pddenhar/hw_microRusEfi/microRusEfi.kicad_pcb

## KiCad design microRusEfi.kicad_pcb (2019-11-08)

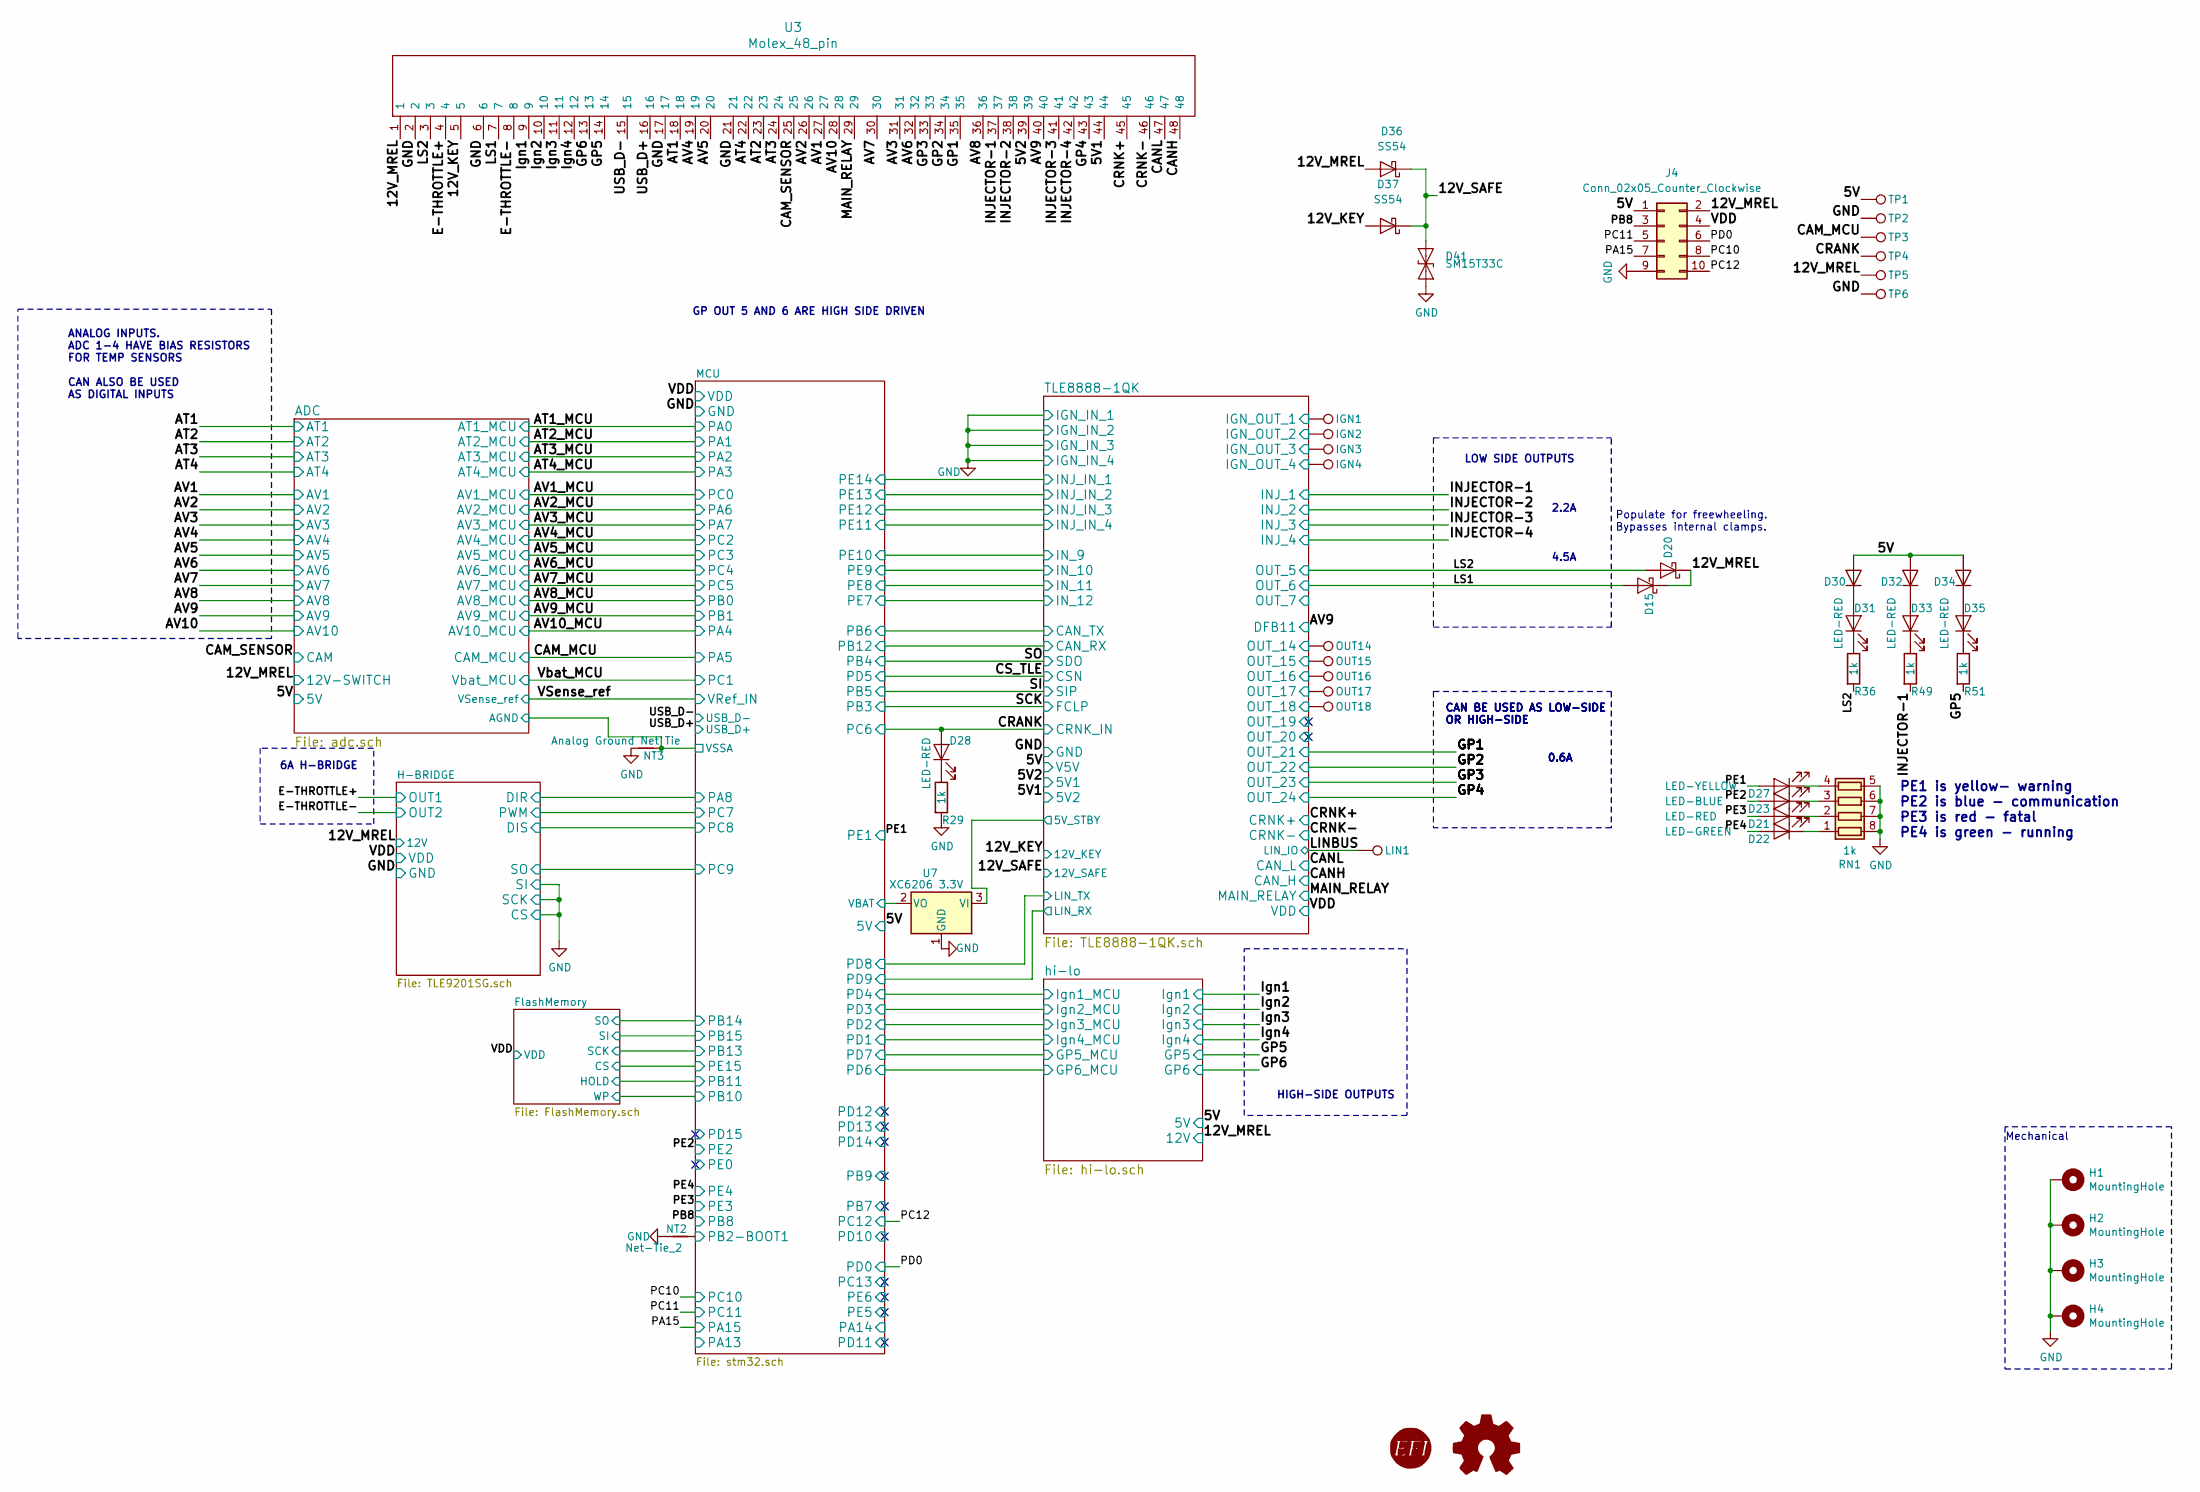
[picture p1: schematic microRusEfi.sch, microRusEfi-2L]

Parts:
D15, D20: DNP; D_SOD-323; Part # NSR0530HT
D21: LED-RED; LED_0805_2012Metric; LCSC C84256
D22: LED-GREEN; LED_0805_2012Metric; LCSC C2297
D23: LED-BLUE; LED_0805_2012Metric; LCSC C2293
D27: LED-YELLOW; LED_0805_2012Metric; LCSC C2296
D28: LED-RED; LED_0603_1608Metric; Part # LTST-C193TBKT-5A; LCSC C2286
D30, D32, D34: 1N4148WS; D_SOD-323; Part # NSR0530HT; LCSC C2128
D31, D33, D35: LED-RED; LED_0603_1608Metric; Part # LTST-S270KRKT; LCSC C2286
D36, D37: SS54; D_SMA; LCSC C22452
D41: SM15T33C; D_SMC
H1, H2, H3, H4: MountingHole; MountingHole_3.5mm_Pad_Via; Part # DNP
IGN1, IGN2, IGN3, IGN4: IGNOUT; Pin_D0.7mm_L6.5mm_W1.8mm_FlatFork; Part # DNP
J4: Conn_02x05_Counter_Clockwise; PinHeader_2x05_P2.54mm_Vertical_SMD
LIN1: LIN; PinHeader_1x01_P2.54mm_Vertical; Part # DNP
LOGO1: DNP; LogoMRE; Part # DNP
LOGO2: DNP; LOGO; Part # DNP
NT2: Net-Tie_2; Net-Tie_2_8.5mil
NT3: Analog Ground Net Tie; NetTie-2_SMD_Pad0.5mm
OUT14: OUT14; Pin_D0.7mm_L6.5mm_W1.8mm_FlatFork; Part # DNP
OUT15: OUT15; Pin_D0.7mm_L6.5mm_W1.8mm_FlatFork; Part # DNP
OUT16: OUT16; Pin_D0.7mm_L6.5mm_W1.8mm_FlatFork; Part # DNP
OUT17: OUT17; Pin_D0.7mm_L6.5mm_W1.8mm_FlatFork; Part # DNP
OUT18: OUT18; Pin_D0.7mm_L6.5mm_W1.8mm_FlatFork; Part # DNP
R29, R36, R49, R51: 1k; R_0603_1608Metric; Part # RMCF0603JJ1K00; LCSC C21190
RN1: 1k; R_Array_Convex_4x0603; Part # CAT16-1001F4LF; LCSC C20197
TP1, TP5: 5V; TestPoint_Pad_D2.0mm; Part # DNP
TP2, TP6: GND; TestPoint_Pad_D2.0mm; Part # DNP
TP3, TP4: TP; TestPoint_Pad_D2.0mm; Part # DNP
U3: Molex_48_pin; Molex_48; Part # 500762-0481
U7: XC6206 3.3V; SOT-23; LCSC C5446

Connections:
/5V: D30.2 (A), D32.2 (A), D34.2 (A), J4.1, TP1.1; also elsewhere on the board
/5V1: U3.44; also elsewhere on the board
/5V2: U3.39; also elsewhere on the board
/12V_KEY: D37.2 (A), U3.5; also elsewhere on the board
/12V_MREL: D15.1 (K), D20.1 (K), D36.2 (A), J4.2, TP5.1, U3.1; also elsewhere on the board
/12V_SAFE: D36.1 (K), D37.1 (K), D41.1 (A1); also elsewhere on the board
/ADC/AGND: NT3.2; also elsewhere on the board
/AT1: U3.18; also elsewhere on the board
/AT2: U3.23; also elsewhere on the board
/AT3: U3.24; also elsewhere on the board
/AT4: U3.22; also elsewhere on the board
/AV1: U3.27; also elsewhere on the board
/AV2: U3.26; also elsewhere on the board
/AV3: U3.31; also elsewhere on the board
/AV4: U3.19; also elsewhere on the board
/AV5: U3.20; also elsewhere on the board
/AV6: U3.32; also elsewhere on the board
/AV7: U3.30; also elsewhere on the board
/AV8: U3.36; also elsewhere on the board
/AV9: U3.40; also elsewhere on the board
/AV10: U3.28; also elsewhere on the board
/CAM_MCU: TP3.1; also elsewhere on the board
/CAM_SENSOR: U3.25; also elsewhere on the board
/CANH: U3.48; also elsewhere on the board
/CANL: U3.47; also elsewhere on the board
/CRANK: D28.2 (A), TP4.1; also elsewhere on the board
/CRNK+: U3.45; also elsewhere on the board
/CRNK-: U3.46; also elsewhere on the board
/E-THROTTLE+: U3.4; also elsewhere on the board
/E-THROTTLE-: U3.8; also elsewhere on the board
/GP1: U3.35; also elsewhere on the board
/GP2: U3.34; also elsewhere on the board
/GP3: U3.33; also elsewhere on the board
/GP4: U3.43; also elsewhere on the board
/GP5: R51.2, U3.14; also elsewhere on the board
/GP6: U3.13; also elsewhere on the board
/INJECTOR-1: R49.2, U3.37; also elsewhere on the board
/INJECTOR-2: U3.38; also elsewhere on the board
/INJECTOR-3: U3.41; also elsewhere on the board
/INJECTOR-4: U3.42; also elsewhere on the board
/Ign1: U3.9; also elsewhere on the board
/Ign2: U3.10; also elsewhere on the board
/Ign3: U3.11; also elsewhere on the board
/Ign4: U3.12; also elsewhere on the board
/LINBUS: LIN1.1; also elsewhere on the board
/LS1: D15.2 (A), U3.7; also elsewhere on the board
/LS2: D20.2 (A), R36.2, U3.3; also elsewhere on the board
/MAIN_RELAY: U3.29; also elsewhere on the board
/MCU/PB2-BOOT1: NT2.2; also elsewhere on the board
/MCU/VBAT: U7.2 (VO); also elsewhere on the board
/PA15: J4.7; also elsewhere on the board
/PB8: J4.3; also elsewhere on the board
/PC10: J4.8; also elsewhere on the board
/PC11: J4.5; also elsewhere on the board
/PC12: J4.10; also elsewhere on the board
/PD0: J4.6; also elsewhere on the board
/PE1: D27.2 (A); also elsewhere on the board
/PE2: D23.2 (A); also elsewhere on the board
/PE3: D21.2 (A); also elsewhere on the board
/PE4: D22.2 (A); also elsewhere on the board
/TLE8888-1QK/5V_STBY: U7.3 (VI); also elsewhere on the board
/TLE8888-1QK/IGN_OUT_1: IGN1.1; also elsewhere on the board
/TLE8888-1QK/IGN_OUT_2: IGN2.1; also elsewhere on the board
/TLE8888-1QK/IGN_OUT_3: IGN3.1; also elsewhere on the board
/TLE8888-1QK/IGN_OUT_4: IGN4.1; also elsewhere on the board
/TLE8888-1QK/OUT_14: OUT14.1; also elsewhere on the board
/TLE8888-1QK/OUT_15: OUT15.1; also elsewhere on the board
/TLE8888-1QK/OUT_16: OUT16.1; also elsewhere on the board
/TLE8888-1QK/OUT_17: OUT17.1; also elsewhere on the board
/TLE8888-1QK/OUT_18: OUT18.1; also elsewhere on the board
/USB_D+: U3.16; also elsewhere on the board
/USB_D-: U3.15; also elsewhere on the board
/VDD: J4.4; also elsewhere on the board
GND: D41.2 (A2), H1.1, H2.1, H3.1, H4.1, J4.9, NT2.1, NT3.1, R29.2, RN1.5 (R4.2), RN1.6 (R3.2), RN1.7 (R2.2), RN1.8 (R1.2), TP2.1, TP6.1, U3.2, U3.6, U3.17, U3.21, U7.1 (GND); also elsewhere on the board
unnamed: D21.1 (K), RN1.2 (R2.1)
unnamed: D22.1 (K), RN1.1 (R1.1)
unnamed: D23.1 (K), RN1.3 (R3.1)
unnamed: D27.1 (K), RN1.4 (R4.1)
unnamed: D28.1 (K), R29.1
unnamed: D30.1 (K), D31.2 (A)
unnamed: D31.1 (K), R36.1
unnamed: D32.1 (K), D33.2 (A)
unnamed: D33.1 (K), R49.1
unnamed: D34.1 (K), D35.2 (A)
unnamed: D35.1 (K), R51.1

Notes on the sheet:
LOW SIDE OUTPUTS
4.5A
0.6A
2.2A
HIGH-SIDE OUTPUTS
ANALOG INPUTS. ADC 1-4 HAVE BIAS RESISTORS FOR TEMP SENSORS CAN ALSO BE USED AS DIGITAL INPUTS
CAN BE USED AS LOW-SIDE OR HIGH-SIDE
GP OUT 5 AND 6 ARE HIGH SIDE DRIVEN
6A H-BRIDGE
PE1 is yellow- warning PE2 is blue - communication PE3 is red - fatal PE4 is green - running
Populate for freewheeling. Bypasses internal clamps.
Mechanical

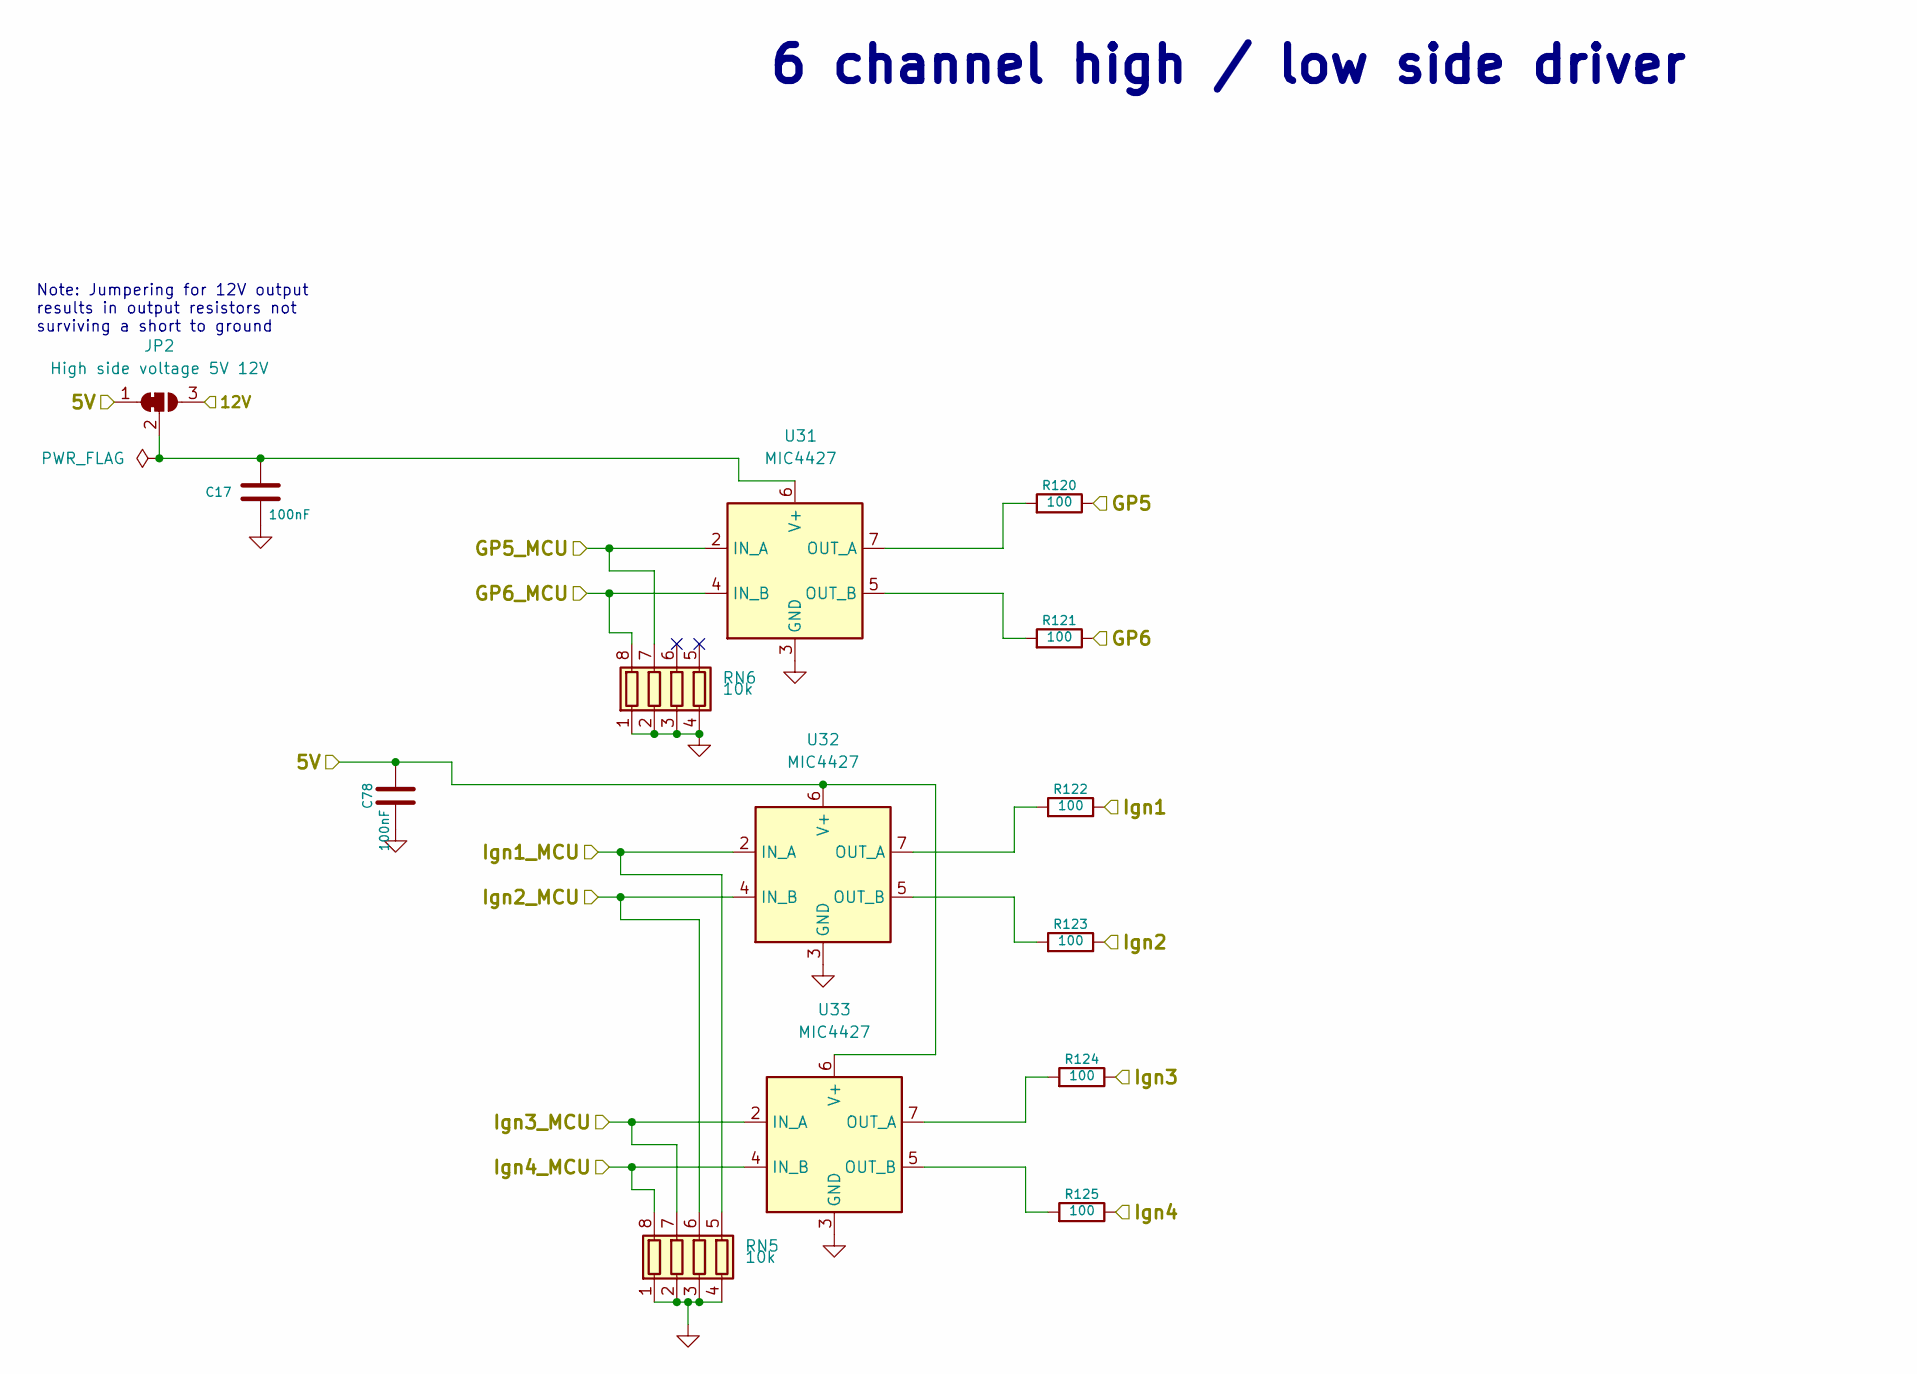
[picture p2: schematic hi-lo.sch, microRusEfi-2L]

Parts:
C17, C78: 100nF; C_0603_1608Metric; LCSC C14663
JP2: High side voltage 5V 12V; SolderJumper-3_P1.3mm_Bridged2Bar12_Pad1.0x1.5mm
R120, R121, R122, R123, R124, R125: 100; R_1206_3216Metric; Part # RMCF0603FT100R; LCSC C17901
RN5, RN6: 10k; R_Array_Convex_4x0603; LCSC C29718
U31, U32, U33: MIC4427; SOIC-8_3.9x4.9mm_P1.27mm; LCSC C144205

Connections:
/5V: C78.1, JP2.1 (A), U32.6 (V+), U33.6 (V+); also elsewhere on the board
/12V_MREL: JP2.3 (B); also elsewhere on the board
/GP5: R120.1; also elsewhere on the board
/GP6: R121.1; also elsewhere on the board
/Ign1: R122.1; also elsewhere on the board
/Ign2: R123.1; also elsewhere on the board
/Ign3: R124.1; also elsewhere on the board
/Ign4: R125.1; also elsewhere on the board
/hi-lo/GP5_MCU: RN6.7 (R2.2), U31.2 (IN_A); also elsewhere on the board
/hi-lo/GP6_MCU: RN6.8 (R1.2), U31.4 (IN_B); also elsewhere on the board
/hi-lo/Ign1_MCU: RN5.5 (R4.2), U32.2 (IN_A); also elsewhere on the board
/hi-lo/Ign2_MCU: RN5.6 (R3.2), U32.4 (IN_B); also elsewhere on the board
/hi-lo/Ign3_MCU: RN5.7 (R2.2), U33.2 (IN_A); also elsewhere on the board
/hi-lo/Ign4_MCU: RN5.8 (R1.2), U33.4 (IN_B); also elsewhere on the board
GND: C17.2, C78.2, RN5.1 (R1.1), RN5.2 (R2.1), RN5.3 (R3.1), RN5.4 (R4.1), RN6.1 (R1.1), RN6.2 (R2.1), RN6.3 (R3.1), RN6.4 (R4.1), U31.3 (GND), U32.3 (GND), U33.3 (GND); also elsewhere on the board
unnamed: C17.1, JP2.2 (C), U31.6 (V+)
unnamed: R120.2, U31.7 (OUT_A)
unnamed: R121.2, U31.5 (OUT_B)
unnamed: R122.2, U32.7 (OUT_A)
unnamed: R123.2, U32.5 (OUT_B)
unnamed: R124.2, U33.7 (OUT_A)
unnamed: R125.2, U33.5 (OUT_B)

Notes on the sheet:
6 channel high / low side driver
Note: Jumpering for 12V output results in output resistors not surviving a short to ground

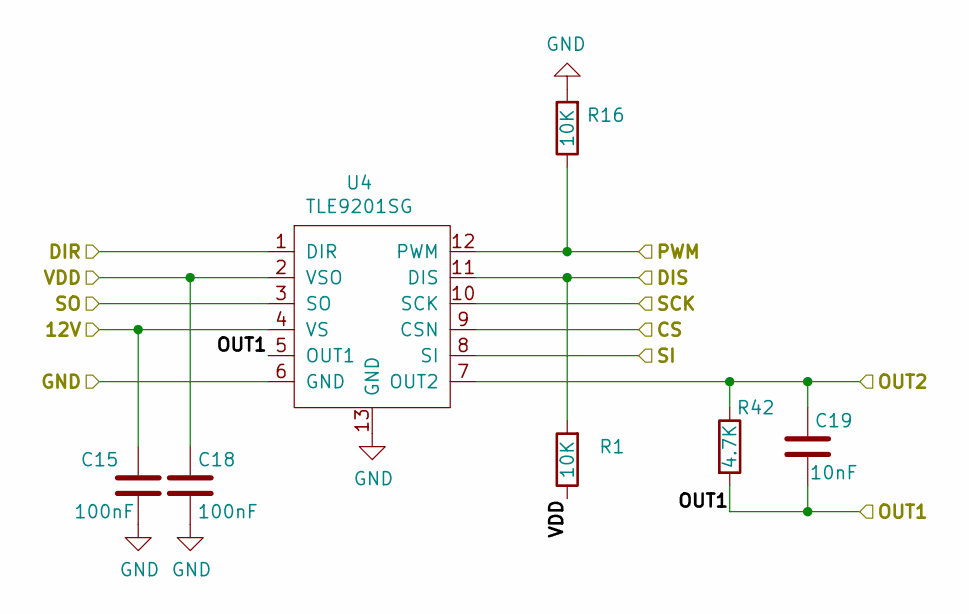
[picture p3: schematic TLE9201SG.sch, microRusEfi-2L]

Parts:
C15, C18: 100nF; C_0603_1608Metric; Part # C0603C104J5RACTU; LCSC C14663
C19: 10nF; C_0603_1608Metric; Part # C0603C103K1RACTU; LCSC C57112
R1, R16: 10K; R_0603_1608Metric; Part # RMCF0603JT10K0; LCSC C25804
R42: 4.7K; R_0603_1608Metric; Part # RMCF0603JT4K70; LCSC C23162
U4: TLE9201SG; Infineon_PG-DSO-12-11; Part # TLE9201SG

Connections:
/12V_MREL: C15.1, U4.4 (VS); also elsewhere on the board
/E-THROTTLE+: C19.2, R42.2, U4.5 (OUT1); also elsewhere on the board
/E-THROTTLE-: C19.1, R42.1, U4.7 (OUT2); also elsewhere on the board
/H-BRIDGE/DIR: U4.1 (DIR); also elsewhere on the board
/H-BRIDGE/DIS: R1.2, U4.11 (DIS); also elsewhere on the board
/MCU/PC7: R16.1, U4.12 (PWM); also elsewhere on the board
/MCU/PC9: U4.3 (SO); also elsewhere on the board
/VDD: C18.1, R1.1, U4.2 (VSO); also elsewhere on the board
GND: C15.2, C18.2, R16.2, U4.6 (GND), U4.8 (SI), U4.9 (CSN), U4.10 (SCK), U4.13 (GND); also elsewhere on the board

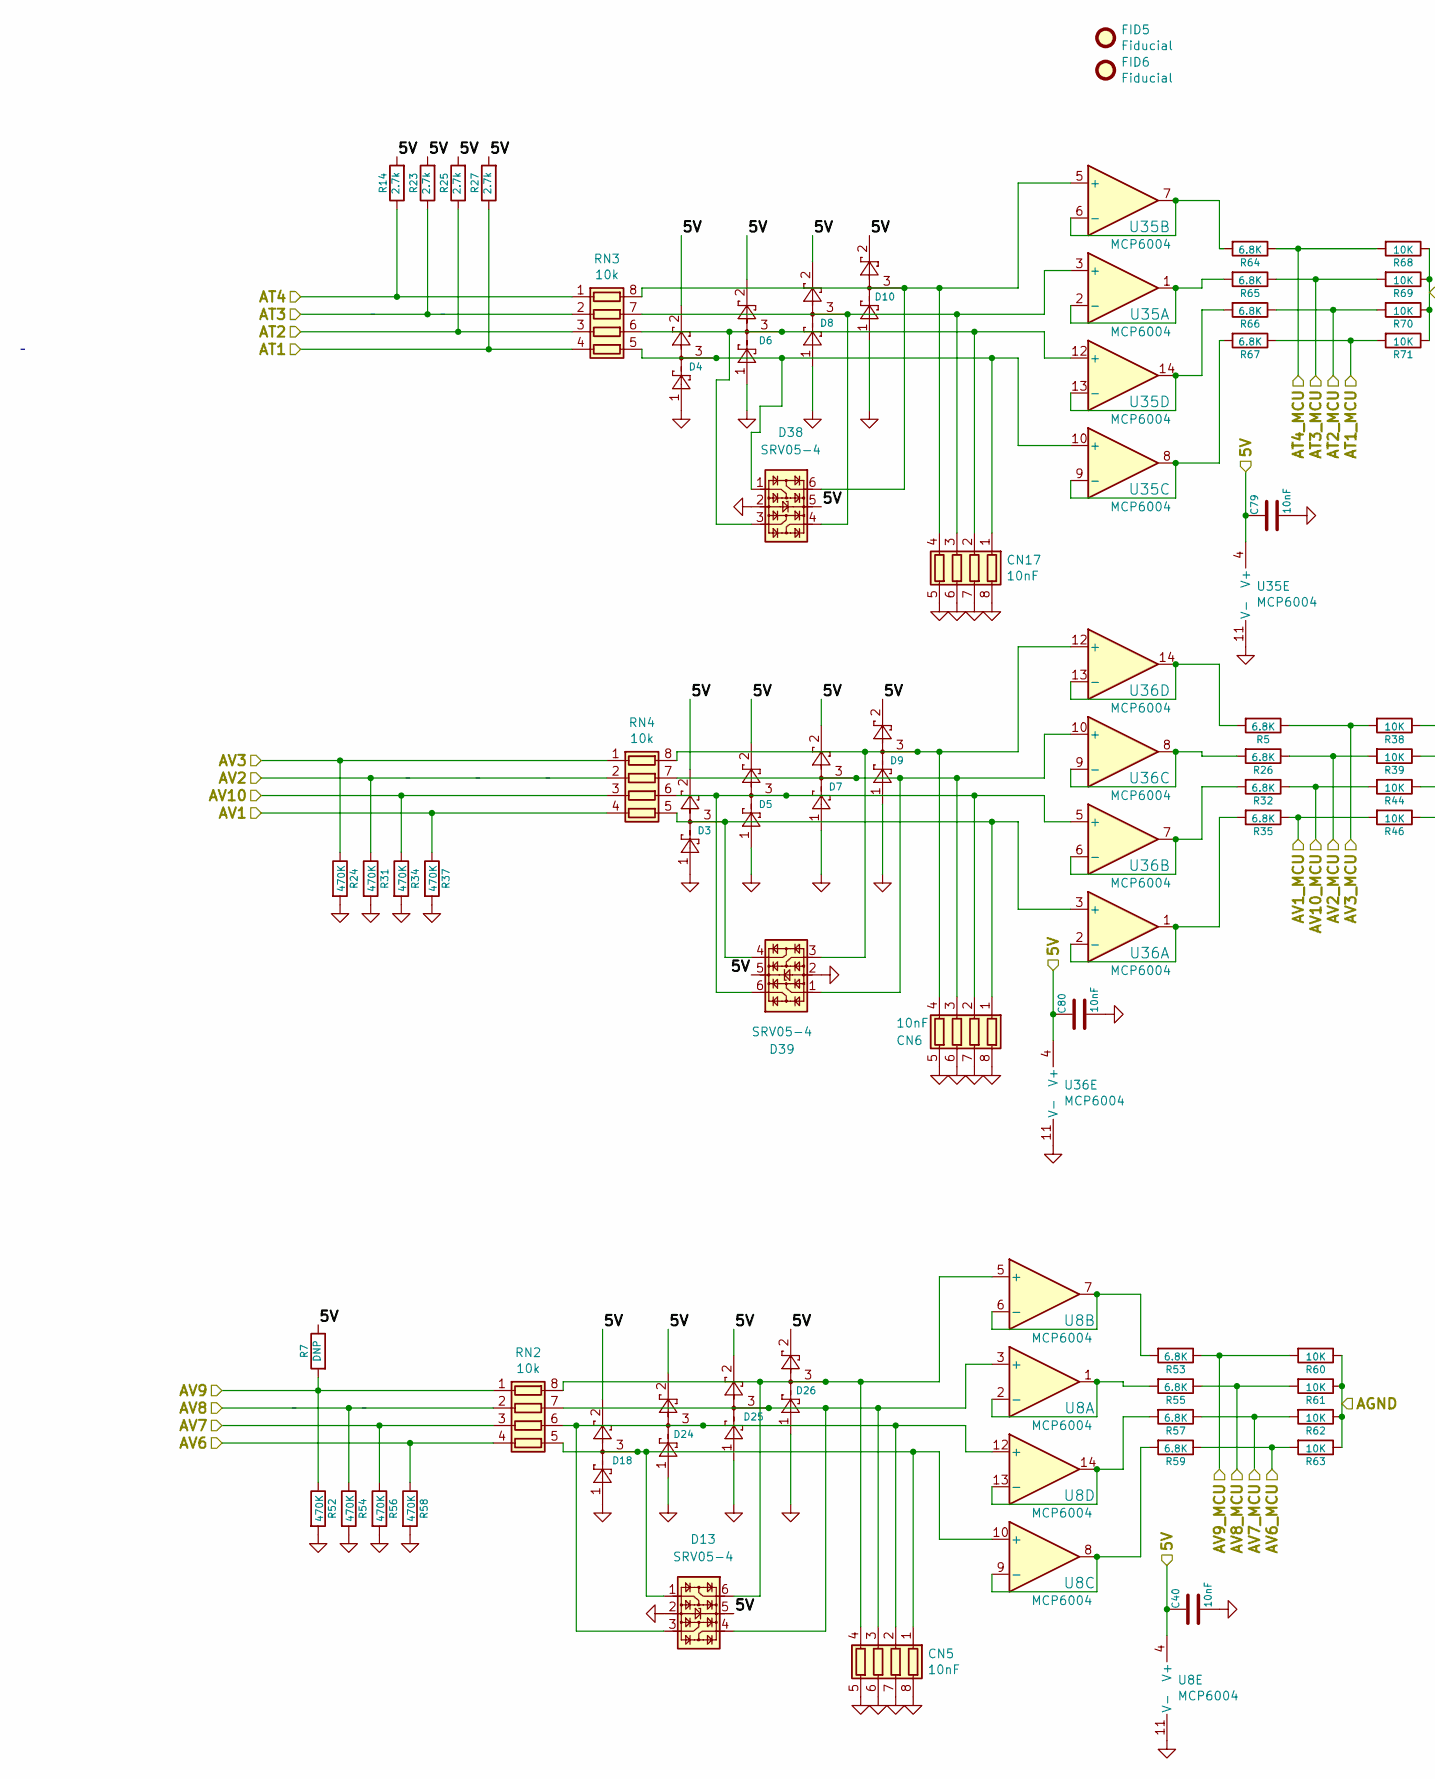
[picture p4: schematic adc.sch, microRusEfi-2L, part in row 1, column 1]

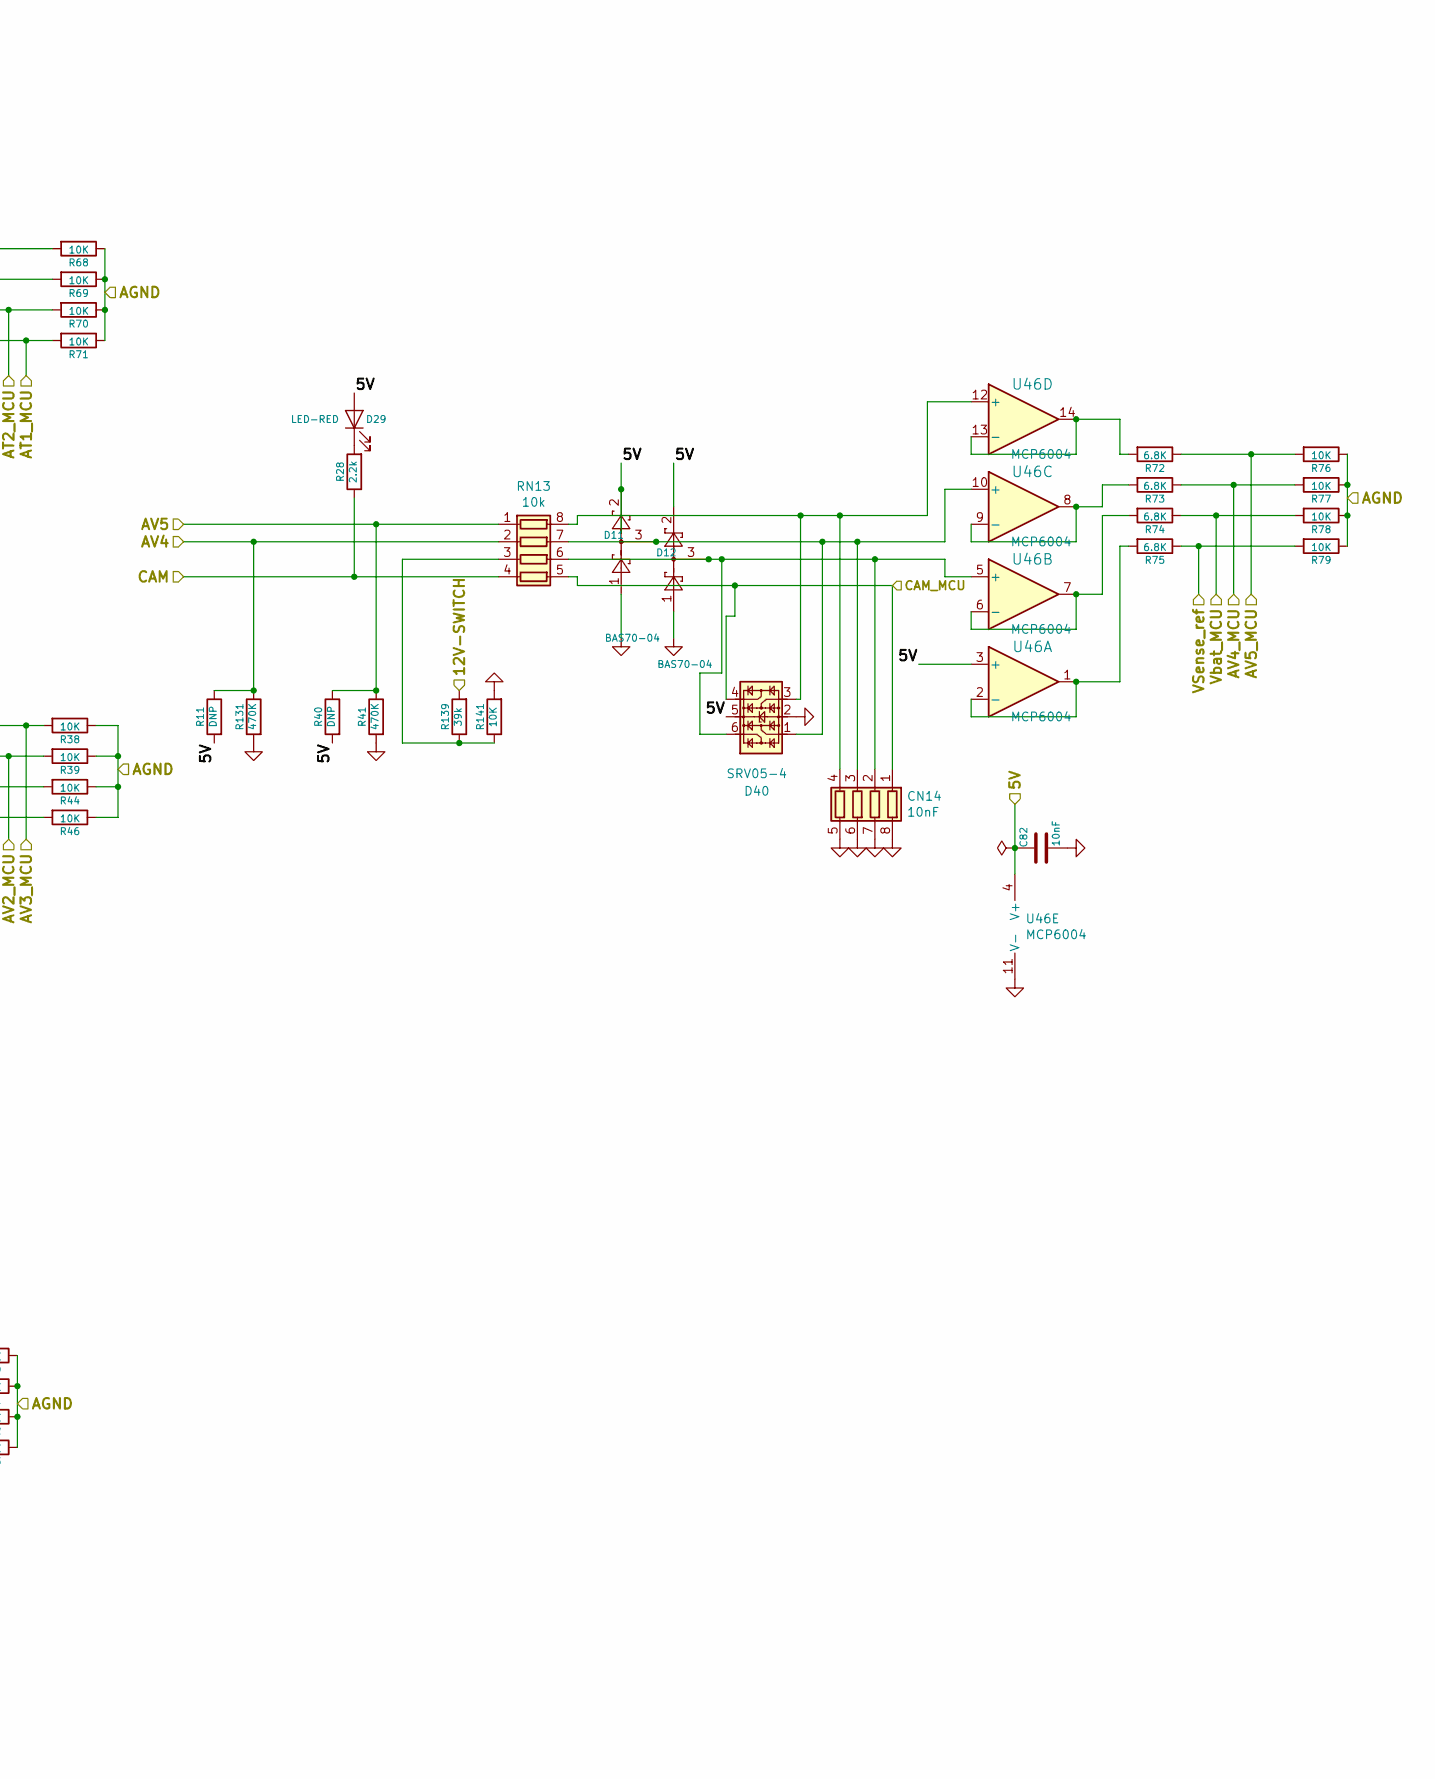
[picture p5: schematic adc.sch, microRusEfi-2L, part in row 1, column 2]

Parts:
C40, C79, C80, C82: 10nF; C_0603_1608Metric; Part # C0603C103K1RACTU; LCSC C57112
CN5, CN6, CN14, CN17: 10nF; R_Array_Convex_4x0603; Part # CA064X103K2RACAUTO
D3, D4, D5, D6, D7, D8, D9, D10, D11, D12, D18, D24, D25, D26: BAS70-04; SOT-23; Part # SBAS70-04LT1G
D13, D38, D39, D40: SRV05-4; SOT-23-6; LCSC C85364
D29: LED-RED; LED_0603_1608Metric; Part # LTST-C193TBKT-5A; LCSC C2286
FID5, FID6: Fiducial; Fiducial_0.5mm_Mask1mm; Part # DNP
R5, R26, R32, R35, R53, R55, R57, R59, R64, R65, R66, R67, R72, R73, R74, R75: 6.8K; R_0603_1608Metric; LCSC C23212
R7, R11, R40: DNP; R_0603_1608Metric; Part # DNP
R14, R23, R25, R27: 2.7k; R_0603_1608Metric; Part # RMCF0603FT2K70; LCSC C13167
R24, R31, R34, R37, R41, R52, R54, R56, R58, R131: 470K; R_0603_1608Metric; Part # RMCF0603FT470K; LCSC C23178
R28: 2.2k; R_0603_1608Metric; Part # RMCF0603FT2K20; LCSC C4190
R38, R39, R44, R46, R60, R61, R62, R63, R68, R69, R70, R71, R76, R77, R78, R79: 10K; R_0603_1608Metric; LCSC C25804
R139: 39k; R_0603_1608Metric; Part # RC0603FR-0739KL; LCSC C23153
R141: 10K; R_0603_1608Metric; Part # RMCF0603JT10K0; LCSC C25804
RN2, RN3, RN4, RN13: 10k; R_Array_Convex_4x0603; Part # YC164-JR-0710KL; LCSC C29718
U8, U35, U36, U46: MCP6004; TSSOP-14_4.4x5mm_P0.65mm; Part # MCP6004T-I/ST; LCSC C50282

Connections:
/5V: C40.1, C79.1, C80.1, C82.1, D3.2, D4.2, D5.2, D6.2, D7.2, D8.2, D9.2, D10.2, D11.2, D12.2, D13.5, D18.2, D24.2, D25.2, D26.2, D29.2 (A), D38.5, D39.5, D40.5, R7.1, R11.2, R14.2, R23.2, R25.2, R27.2, R40.2, U8.4 (V+), U35.4 (V+), U36.4 (V+), U46.3 (+), U46.4 (V+); also elsewhere on the board
/12V_MREL: R139.2; also elsewhere on the board
/ADC/AGND: R38.1, R39.1, R44.1, R46.1, R60.1, R61.1, R62.1, R63.1, R68.1, R69.1, R70.1, R71.1, R76.1, R77.1, R78.1, R79.1; also elsewhere on the board
/AT1: R27.1, RN3.4 (R4.1); also elsewhere on the board
/AT1_MCU: R67.1, R71.2; also elsewhere on the board
/AT2: R25.1, RN3.3 (R3.1); also elsewhere on the board
/AT2_MCU: R66.1, R70.2; also elsewhere on the board
/AT3: R23.1, RN3.2 (R2.1); also elsewhere on the board
/AT3_MCU: R65.1, R69.2; also elsewhere on the board
/AT4: R14.1, RN3.1 (R1.1); also elsewhere on the board
/AT4_MCU: R64.1, R68.2; also elsewhere on the board
/AV1: R37.1, RN4.4 (R4.1); also elsewhere on the board
/AV1_MCU: R35.1, R46.2; also elsewhere on the board
/AV2: R31.1, RN4.2 (R2.1); also elsewhere on the board
/AV2_MCU: R26.1, R39.2; also elsewhere on the board
/AV3: R24.1, RN4.1 (R1.1); also elsewhere on the board
/AV3_MCU: R5.1, R38.2; also elsewhere on the board
/AV4: R11.1, R131.1, RN13.2 (R2.1); also elsewhere on the board
/AV4_MCU: R73.1, R77.2; also elsewhere on the board
/AV5: R40.1, R41.1, RN13.1 (R1.1); also elsewhere on the board
/AV5_MCU: R72.1, R76.2; also elsewhere on the board
/AV6: R58.1, RN2.4 (R4.1); also elsewhere on the board
/AV6_MCU: R59.1, R63.2; also elsewhere on the board
/AV7: R56.1, RN2.3 (R3.1); also elsewhere on the board
/AV7_MCU: R57.1, R62.2; also elsewhere on the board
/AV8: R54.1, RN2.2 (R2.1); also elsewhere on the board
/AV8_MCU: R55.1, R61.2; also elsewhere on the board
/AV9: R7.2, R52.1, RN2.1 (R1.1); also elsewhere on the board
/AV9_MCU: R53.1, R60.2; also elsewhere on the board
/AV10: R34.1, RN4.3 (R3.1); also elsewhere on the board
/AV10_MCU: R32.1, R44.2; also elsewhere on the board
/CAM_MCU: CN14.1 (R1.1), D40.4, RN13.5 (R4.2); also elsewhere on the board
/CAM_SENSOR: R28.1, RN13.4 (R4.1); also elsewhere on the board
/VSense_ref: R75.1, R79.2; also elsewhere on the board
/Vbat_MCU: R74.1, R78.2; also elsewhere on the board
GND: C40.2, C79.2, C80.2, C82.2, CN5.5 (R4.2), CN5.6 (R3.2), CN5.7 (R2.2), CN5.8 (R1.2), CN6.5 (R4.2), CN6.6 (R3.2), CN6.7 (R2.2), CN6.8 (R1.2), CN14.5 (R4.2), CN14.6 (R3.2), CN14.7 (R2.2), CN14.8 (R1.2), CN17.5 (R4.2), CN17.6 (R3.2), CN17.7 (R2.2), CN17.8 (R1.2), D3.1, D4.1, D5.1, D6.1, D7.1, D8.1, D9.1, D10.1, D11.1, D12.1, D13.2, D18.1, D24.1, D25.1, D26.1, D38.2, D39.2, D40.2, R24.2, R31.2, R34.2, R37.2, R41.2, R52.2, R54.2, R56.2, R58.2, R131.2, R141.2, U8.11 (V-), U35.11 (V-), U36.11 (V-), U46.11 (V-); also elsewhere on the board
unnamed: CN5.1 (R1.1), D13.1, D18.3, RN2.5 (R4.2), U8.10 (+)
unnamed: CN5.2 (R2.1), D13.3, D24.3, RN2.6 (R3.2), U8.12 (+)
unnamed: CN5.3 (R3.1), D13.4, D25.3, RN2.7 (R2.2), U8.3 (+)
unnamed: CN5.4 (R4.1), D13.6, D26.3, RN2.8 (R1.2), U8.5 (+)
unnamed: CN6.1 (R1.1), D3.3, D39.4, RN4.5 (R4.2), U36.3 (+)
unnamed: CN6.2 (R2.1), D5.3, D39.6, RN4.6 (R3.2), U36.5 (+)
unnamed: CN6.3 (R3.1), D7.3, D39.1, RN4.7 (R2.2), U36.10 (+)
unnamed: CN6.4 (R4.1), D9.3, D39.3, RN4.8 (R1.2), U36.12 (+)
unnamed: CN14.2 (R2.1), D12.3, D40.6, RN13.6 (R3.2), U46.5 (+)
unnamed: CN14.3 (R3.1), D11.3, D40.1, RN13.7 (R2.2), U46.10 (+)
unnamed: CN14.4 (R4.1), D40.3, RN13.8 (R1.2), U46.12 (+)
unnamed: CN17.1 (R1.1), D4.3, D38.1, RN3.5 (R4.2), U35.10 (+)
unnamed: CN17.2 (R2.1), D6.3, D38.3, RN3.6 (R3.2), U35.12 (+)
unnamed: CN17.3 (R3.1), D8.3, D38.4, RN3.7 (R2.2), U35.3 (+)
unnamed: CN17.4 (R4.1), D10.3, D38.6, RN3.8 (R1.2), U35.5 (+)
unnamed: D29.1 (K), R28.2
unnamed: R5.2, U36.13 (-), U36.14
unnamed: R26.2, U36.8, U36.9 (-)
unnamed: R32.2, U36.6 (-), U36.7
unnamed: R35.2, U36.1, U36.2 (-)
unnamed: R53.2, U8.6 (-), U8.7
unnamed: R55.2, U8.1, U8.2 (-)
unnamed: R57.2, U8.13 (-), U8.14
unnamed: R59.2, U8.8, U8.9 (-)
unnamed: R64.2, U35.6 (-), U35.7
unnamed: R65.2, U35.1, U35.2 (-)
unnamed: R66.2, U35.13 (-), U35.14
unnamed: R67.2, U35.8, U35.9 (-)
unnamed: R72.2, U46.13 (-), U46.14
unnamed: R73.2, U46.8, U46.9 (-)
unnamed: R74.2, U46.6 (-), U46.7
unnamed: R75.2, U46.1, U46.2 (-)
unnamed: R139.1, R141.1, RN13.3 (R3.1)
