pddenhar/hw_microRusEfi/microRusEfi.kicad_pcb

## KiCad design microRusEfi.kicad_pcb (continued)

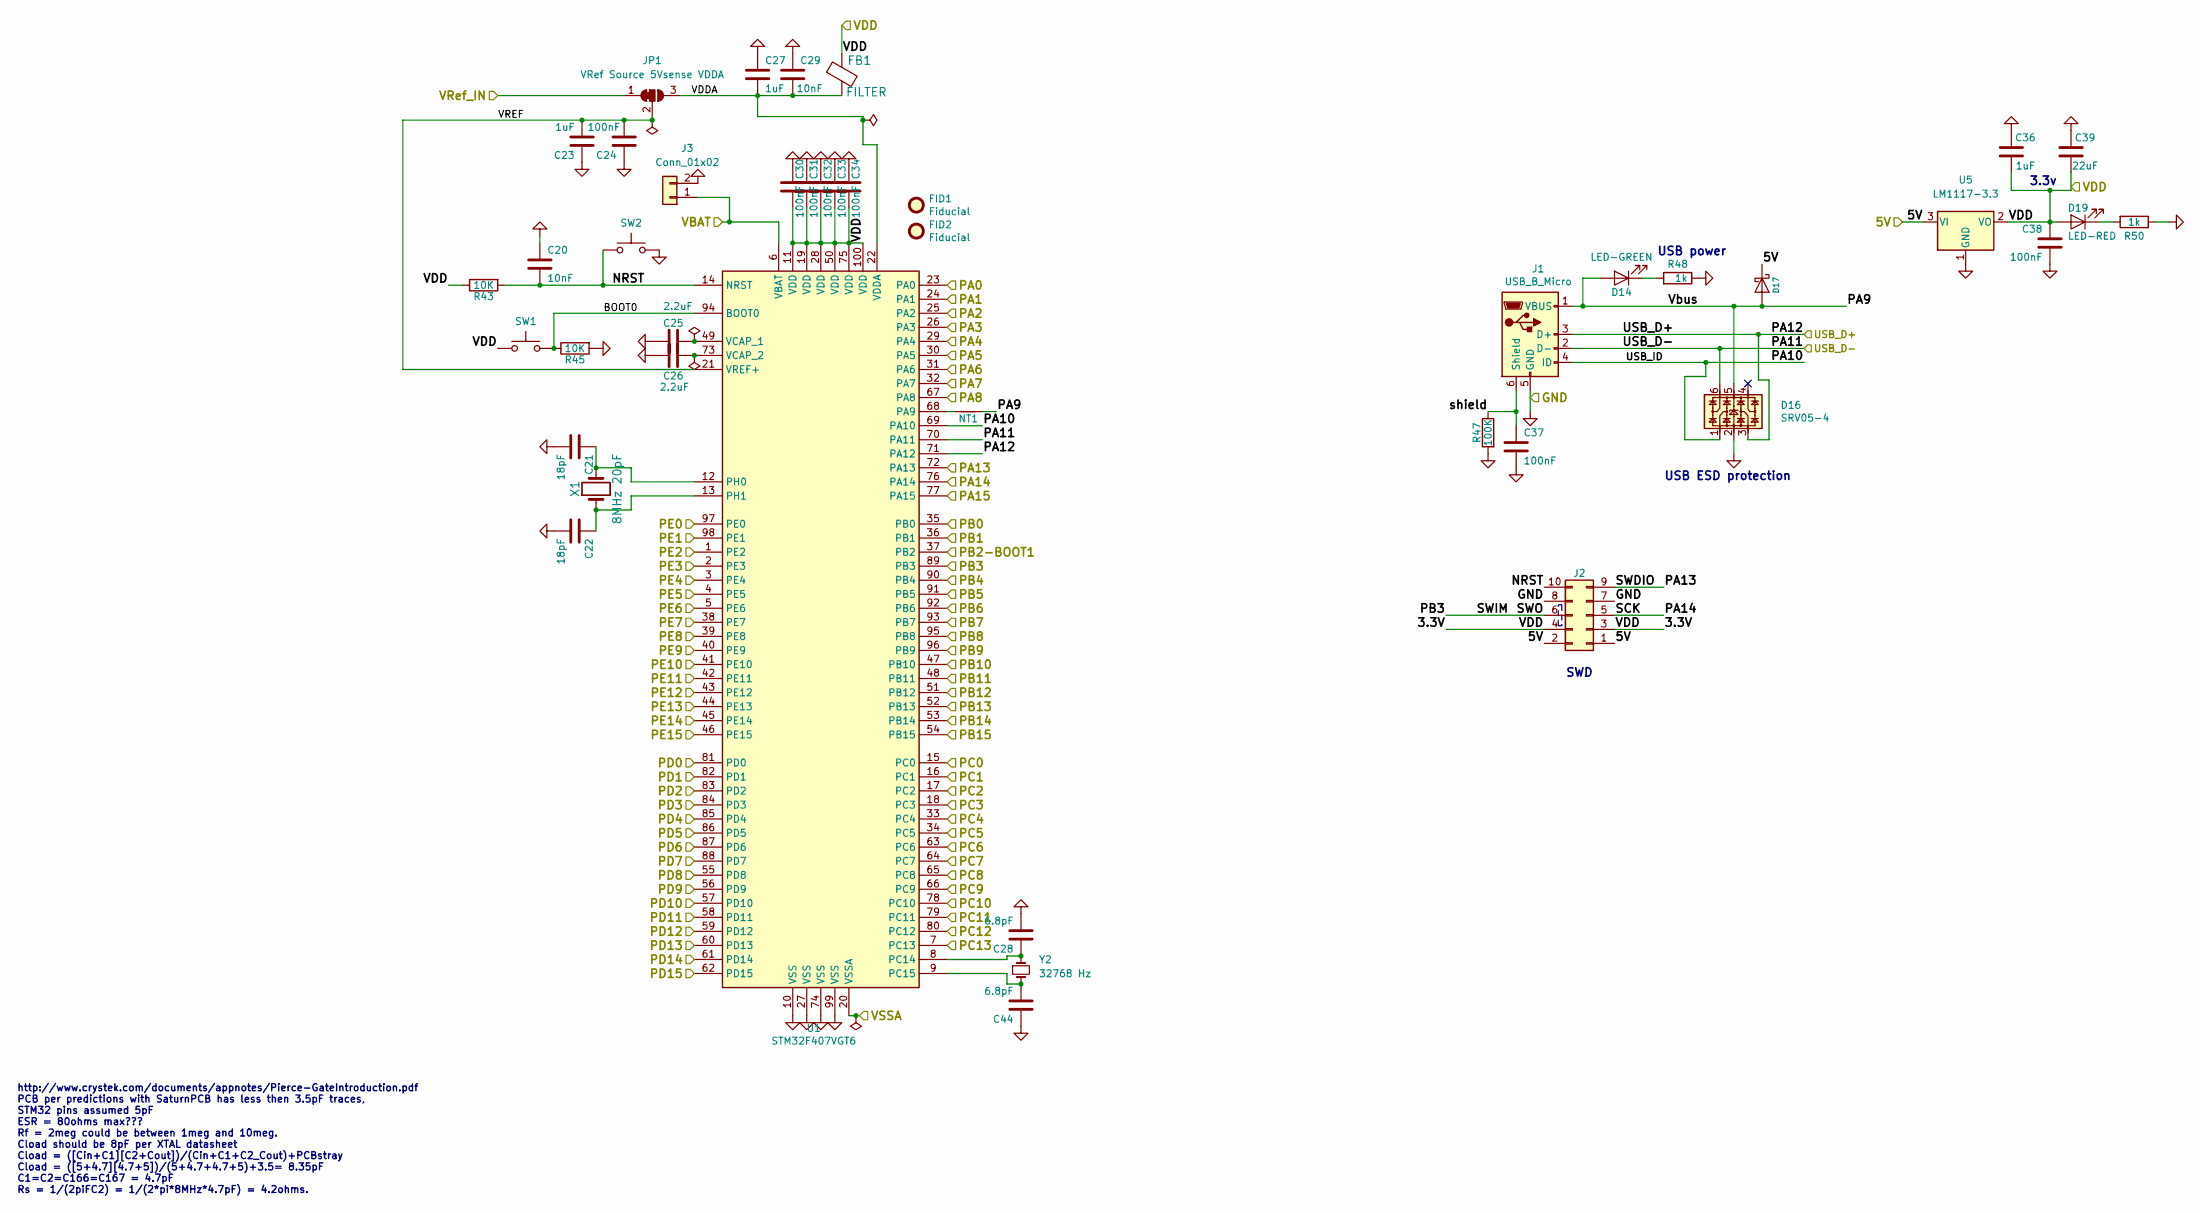
[picture p6: schematic stm32.sch, microRusEfi-2L]

Parts:
C20, C29: 10nF; C_0603_1608Metric; Part # C0603C103K1RACTU; LCSC C57112
C21, C22: 18pF; C_0603_1608Metric; Part # CC0603CRNPO9BN4R7; LCSC C1647
C23, C27, C36: 1uF; C_0603_1608Metric; Part # UMK107BJ105KA-T; LCSC C15849
C24, C30, C31, C32, C33, C34: 100nF; C_0603_1608Metric; LCSC C14663
C25, C26: 2.2uF; C_0603_1608Metric; Part # GRM188R6YA225KA12D; LCSC C23630
C28, C44: 6.8pF; C_0603_1608Metric; LCSC C1679
C37, C38: 100nF; C_0603_1608Metric; Part # C0603C104J5RACTU; LCSC C14663
C39: 22uF; C_0603_1608Metric; LCSC C59461
D14: LED-GREEN; C_0805_2012Metric; LCSC C2297
D16: SRV05-4; SOT-23-6; Part # SRV05-4; LCSC C85364
D17: B5819W; D_SOD-123; LCSC C8598
D19: LED-RED; LED_0603_1608Metric; LCSC C2286
FB1: FILTER; R_0603_1608Metric_Pad1.05x0.95mm_HandSolder; Part # BLM21PG221SN1D; LCSC C1034
FID1, FID2: Fiducial; Fiducial_0.5mm_Mask1mm; Part # DNP
J1: USB_B_Micro; USB_Micro-B_Wuerth-614105150721_Vertical; Part # USB3131-30-0230-A
J2: Conn_02x05_Odd_Even; PinSocket_2x05_P2.54mm_Vertical_SMD; Part # 95278-801B10LF
J3: Conn_01x02; Molex_PicoBlade_53047-0210_1x02_P1.25mm_Vertical
JP1: VRef Source 5Vsense VDDA; SolderJumper-3_P1.3mm_Bridged12_Pad1.0x1.5mm
NT1: Net-Tie_2; Net-Tie_2_8.5mil
R43, R45: 10K; R_0603_1608Metric; Part # RMCF0603JT10K0; LCSC C25804
R47: 100K; R_0603_1608Metric; Part # RMCF0603JT100K; LCSC C25803
R48: 1k; R_0603_1608Metric; Part # RMCF0603JJ1K00; LCSC C21190
R50: 1k; R_0603_1608Metric; LCSC C21190
SW1: SW_Push; SW_Push_SPST_NO_Alps_SKRK; Part # TBD
SW2: SW_Push; SW_Push_SPST_NO_Alps_SKRK
U1: STM32F407VGT6; LQFP-100_14x14mm_P0.5mm; Part # STM32F407VGT6; LCSC C12345
U5: LM1117-3.3; SOT-223-3_TabPin2; LCSC C6186
X1: 8MHz 20pF; Crystal_SMD_5032-2Pin_5.0x3.2mm; LCSC C115962
Y2: 32768 Hz; Crystal_SMD_3215-2Pin_3.2x1.5mm; LCSC C32346

Connections:
/5V: D17.1 (K), J2.1, J2.2, U5.3 (VI); also elsewhere on the board
/ADC/AGND: U1.20 (VSSA); also elsewhere on the board
/AT1_MCU: U1.23 (PA0); also elsewhere on the board
/AT2_MCU: U1.24 (PA1); also elsewhere on the board
/AT3_MCU: U1.25 (PA2); also elsewhere on the board
/AT4_MCU: U1.26 (PA3); also elsewhere on the board
/AV1_MCU: U1.15 (PC0); also elsewhere on the board
/AV2_MCU: U1.31 (PA6); also elsewhere on the board
/AV3_MCU: U1.32 (PA7); also elsewhere on the board
/AV4_MCU: U1.17 (PC2); also elsewhere on the board
/AV5_MCU: U1.18 (PC3); also elsewhere on the board
/AV6_MCU: U1.33 (PC4); also elsewhere on the board
/AV7_MCU: U1.34 (PC5); also elsewhere on the board
/AV8_MCU: U1.35 (PB0); also elsewhere on the board
/AV9_MCU: U1.36 (PB1); also elsewhere on the board
/AV10_MCU: U1.29 (PA4); also elsewhere on the board
/CAM_MCU: U1.30 (PA5); also elsewhere on the board
/CRANK: U1.63 (PC6); also elsewhere on the board
/CS_TLE: U1.86 (PD5); also elsewhere on the board
/FlashMemory/CS: U1.46 (PE15); also elsewhere on the board
/FlashMemory/HOLD: U1.48 (PB11); also elsewhere on the board
/H-BRIDGE/DIR: U1.67 (PA8); also elsewhere on the board
/H-BRIDGE/DIS: U1.65 (PC8); also elsewhere on the board
/MCU/BOOT0: R45.1, SW1.2, U1.94 (BOOT0)
/MCU/NRST: C20.2, J2.10, R43.2, SW2.1, U1.14 (NRST)
/MCU/PA9: D14.2 (A), D16.5, D17.2 (A), J1.1 (VBUS), NT1.2
/MCU/PA10: D16.1, J1.4 (ID), U1.69 (PA10)
/MCU/PA13: J2.9, U1.72 (PA13)
/MCU/PA14: J2.5, U1.76 (PA14)
/MCU/PB2-BOOT1: U1.37 (PB2); also elsewhere on the board
/MCU/PB7: U1.93 (PB7)
/MCU/PB9: U1.96 (PB9)
/MCU/PB10: U1.47 (PB10); also elsewhere on the board
/MCU/PB13: U1.52 (PB13); also elsewhere on the board
/MCU/PB14: U1.53 (PB14); also elsewhere on the board
/MCU/PB15: U1.54 (PB15); also elsewhere on the board
/MCU/PC7: U1.64 (PC7); also elsewhere on the board
/MCU/PC9: U1.66 (PC9); also elsewhere on the board
/MCU/PC13: U1.7 (PC13)
/MCU/PD10: U1.57 (PD10)
/MCU/PD11: U1.58 (PD11)
/MCU/PD12: U1.59 (PD12)
/MCU/PD13: U1.60 (PD13)
/MCU/PD14: U1.61 (PD14)
/MCU/PD15: U1.62 (PD15)
/MCU/PE0: U1.97 (PE0)
/MCU/PE5: U1.4 (PE5)
/MCU/PE6: U1.5 (PE6)
/MCU/VBAT: J3.1, U1.6 (VBAT); also elsewhere on the board
/MCU/VDDA: C27.2, C29.2, FB1.2, JP1.3 (B), U1.22 (VDDA)
/MCU/VREF: C23.2, C24.2, JP1.2 (C), U1.21 (VREF+)
/MCU/shield: C37.1, J1.6 (Shield), R47.1
/PA15: U1.77 (PA15); also elsewhere on the board
/PB8: U1.95 (PB8); also elsewhere on the board
/PC10: U1.78 (PC10); also elsewhere on the board
/PC11: U1.79 (PC11); also elsewhere on the board
/PC12: U1.80 (PC12); also elsewhere on the board
/PD0: U1.81 (PD0); also elsewhere on the board
/PE1: U1.98 (PE1); also elsewhere on the board
/PE2: U1.1 (PE2); also elsewhere on the board
/PE3: U1.2 (PE3); also elsewhere on the board
/PE4: U1.3 (PE4); also elsewhere on the board
/SCK: J2.6, U1.89 (PB3); also elsewhere on the board
/SI: U1.91 (PB5); also elsewhere on the board
/SO: U1.90 (PB4); also elsewhere on the board
/TLE8888-1QK/CAN_RX: U1.51 (PB12); also elsewhere on the board
/TLE8888-1QK/CAN_TX: U1.92 (PB6); also elsewhere on the board
/TLE8888-1QK/INJ_IN_1: U1.45 (PE14); also elsewhere on the board
/TLE8888-1QK/INJ_IN_2: U1.44 (PE13); also elsewhere on the board
/TLE8888-1QK/INJ_IN_3: U1.43 (PE12); also elsewhere on the board
/TLE8888-1QK/INJ_IN_4: U1.42 (PE11); also elsewhere on the board
/TLE8888-1QK/IN_9: U1.41 (PE10); also elsewhere on the board
/TLE8888-1QK/IN_10: U1.40 (PE9); also elsewhere on the board
/TLE8888-1QK/IN_11: U1.39 (PE8); also elsewhere on the board
/TLE8888-1QK/IN_12: U1.38 (PE7); also elsewhere on the board
/TLE8888-1QK/LIN_RX: U1.56 (PD9); also elsewhere on the board
/TLE8888-1QK/LIN_TX: U1.55 (PD8); also elsewhere on the board
/USB_D+: D16.3, J1.3 (D+), U1.71 (PA12); also elsewhere on the board
/USB_D-: D16.6, J1.2 (D-), U1.70 (PA11); also elsewhere on the board
/VDD: C30.2, C31.2, C32.2, C33.2, C34.2, C36.2, C38.1, C39.2, D19.2 (A), FB1.1, J2.3, J2.4, R43.1, SW1.1, U1.11 (VDD), U1.19 (VDD), U1.28 (VDD), U1.50 (VDD), U1.75 (VDD), U1.100 (VDD), U5.2 (VO); also elsewhere on the board
/VSense_ref: JP1.1 (A); also elsewhere on the board
/Vbat_MCU: U1.16 (PC1); also elsewhere on the board
/hi-lo/GP5_MCU: U1.88 (PD7); also elsewhere on the board
/hi-lo/GP6_MCU: U1.87 (PD6); also elsewhere on the board
/hi-lo/Ign1_MCU: U1.85 (PD4); also elsewhere on the board
/hi-lo/Ign2_MCU: U1.84 (PD3); also elsewhere on the board
/hi-lo/Ign3_MCU: U1.83 (PD2); also elsewhere on the board
/hi-lo/Ign4_MCU: U1.82 (PD1); also elsewhere on the board
GND: C20.1, C21.2, C22.2, C23.1, C24.1, C25.2, C26.2, C27.1, C28.2, C29.1, C30.1, C31.1, C32.1, C33.1, C34.1, C36.1, C37.2, C38.2, C39.1, C44.1, D16.2, J1.5 (GND), J2.7, J2.8, J3.2, R45.2, R47.2, R48.1, R50.1, SW2.2, U1.10 (VSS), U1.27 (VSS), U1.74 (VSS), U1.99 (VSS), U5.1 (GND); also elsewhere on the board
unnamed: C21.1, U1.12 (PH0), X1.2
unnamed: C22.1, U1.13 (PH1), X1.1
unnamed: C25.1, U1.49 (VCAP_1)
unnamed: C26.1, U1.73 (VCAP_2)
unnamed: C28.1, U1.8 (PC14), Y2.1
unnamed: C44.2, U1.9 (PC15), Y2.2
unnamed: D14.1 (K), R48.2
unnamed: D19.1 (K), R50.2
unnamed: NT1.1, U1.68 (PA9)

Notes on the sheet:
SWD
USB power
3.3v
USB ESD protection
http://www.crystek.com/documents/appnotes/Pierce-GateIntroduction.pdf PCB per predictions with SaturnPCB has less then 3.5pF traces, STM32 pins assumed 5pF ESR = 80ohms max??? Rf = 2meg could be between 1meg and 10meg. Cload should be 8pF per XTAL datasheet Cload = ([Cin+C1][C2+Cout])/(Cin+C1+C2_Co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

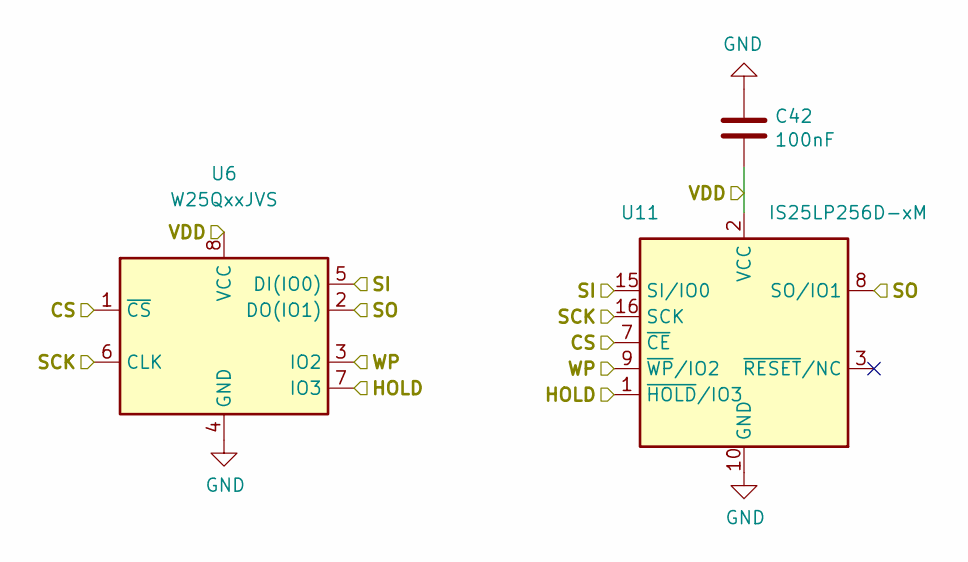
[picture p7: schematic FlashMemory.sch, microRusEfi-2L]

Parts:
C42: 100nF; C_0603_1608Metric; Part # C0603C104J5RACTU; LCSC C14663
U6: W25QxxJVS; SO-8_5.3x6.2mm_P1.27mm-150+208; LCSC C97521
U11: IS25LP256D-xM; SOIC-16W_7.5x10.3mm_P1.27mm; Part # IS25LP256D-RMLE

Connections:
/FlashMemory/CS: U6.1 (~CS), U11.7 (~CE); also elsewhere on the board
/FlashMemory/HOLD: U6.7 (IO3), U11.1 (~HOLD~/IO3); also elsewhere on the board
/MCU/PB10: U6.3 (IO2), U11.9 (~WP~/IO2); also elsewhere on the board
/MCU/PB13: U6.6 (CLK), U11.16 (SCK); also elsewhere on the board
/MCU/PB14: U6.2 (DO(IO1)), U11.8 (SO/IO1); also elsewhere on the board
/MCU/PB15: U6.5 (DI(IO0)), U11.15 (SI/IO0); also elsewhere on the board
/VDD: C42.2, U6.8 (VCC), U11.2 (VCC); also elsewhere on the board
GND: C42.1, U6.4 (GND), U11.10 (GND); also elsewhere on the board

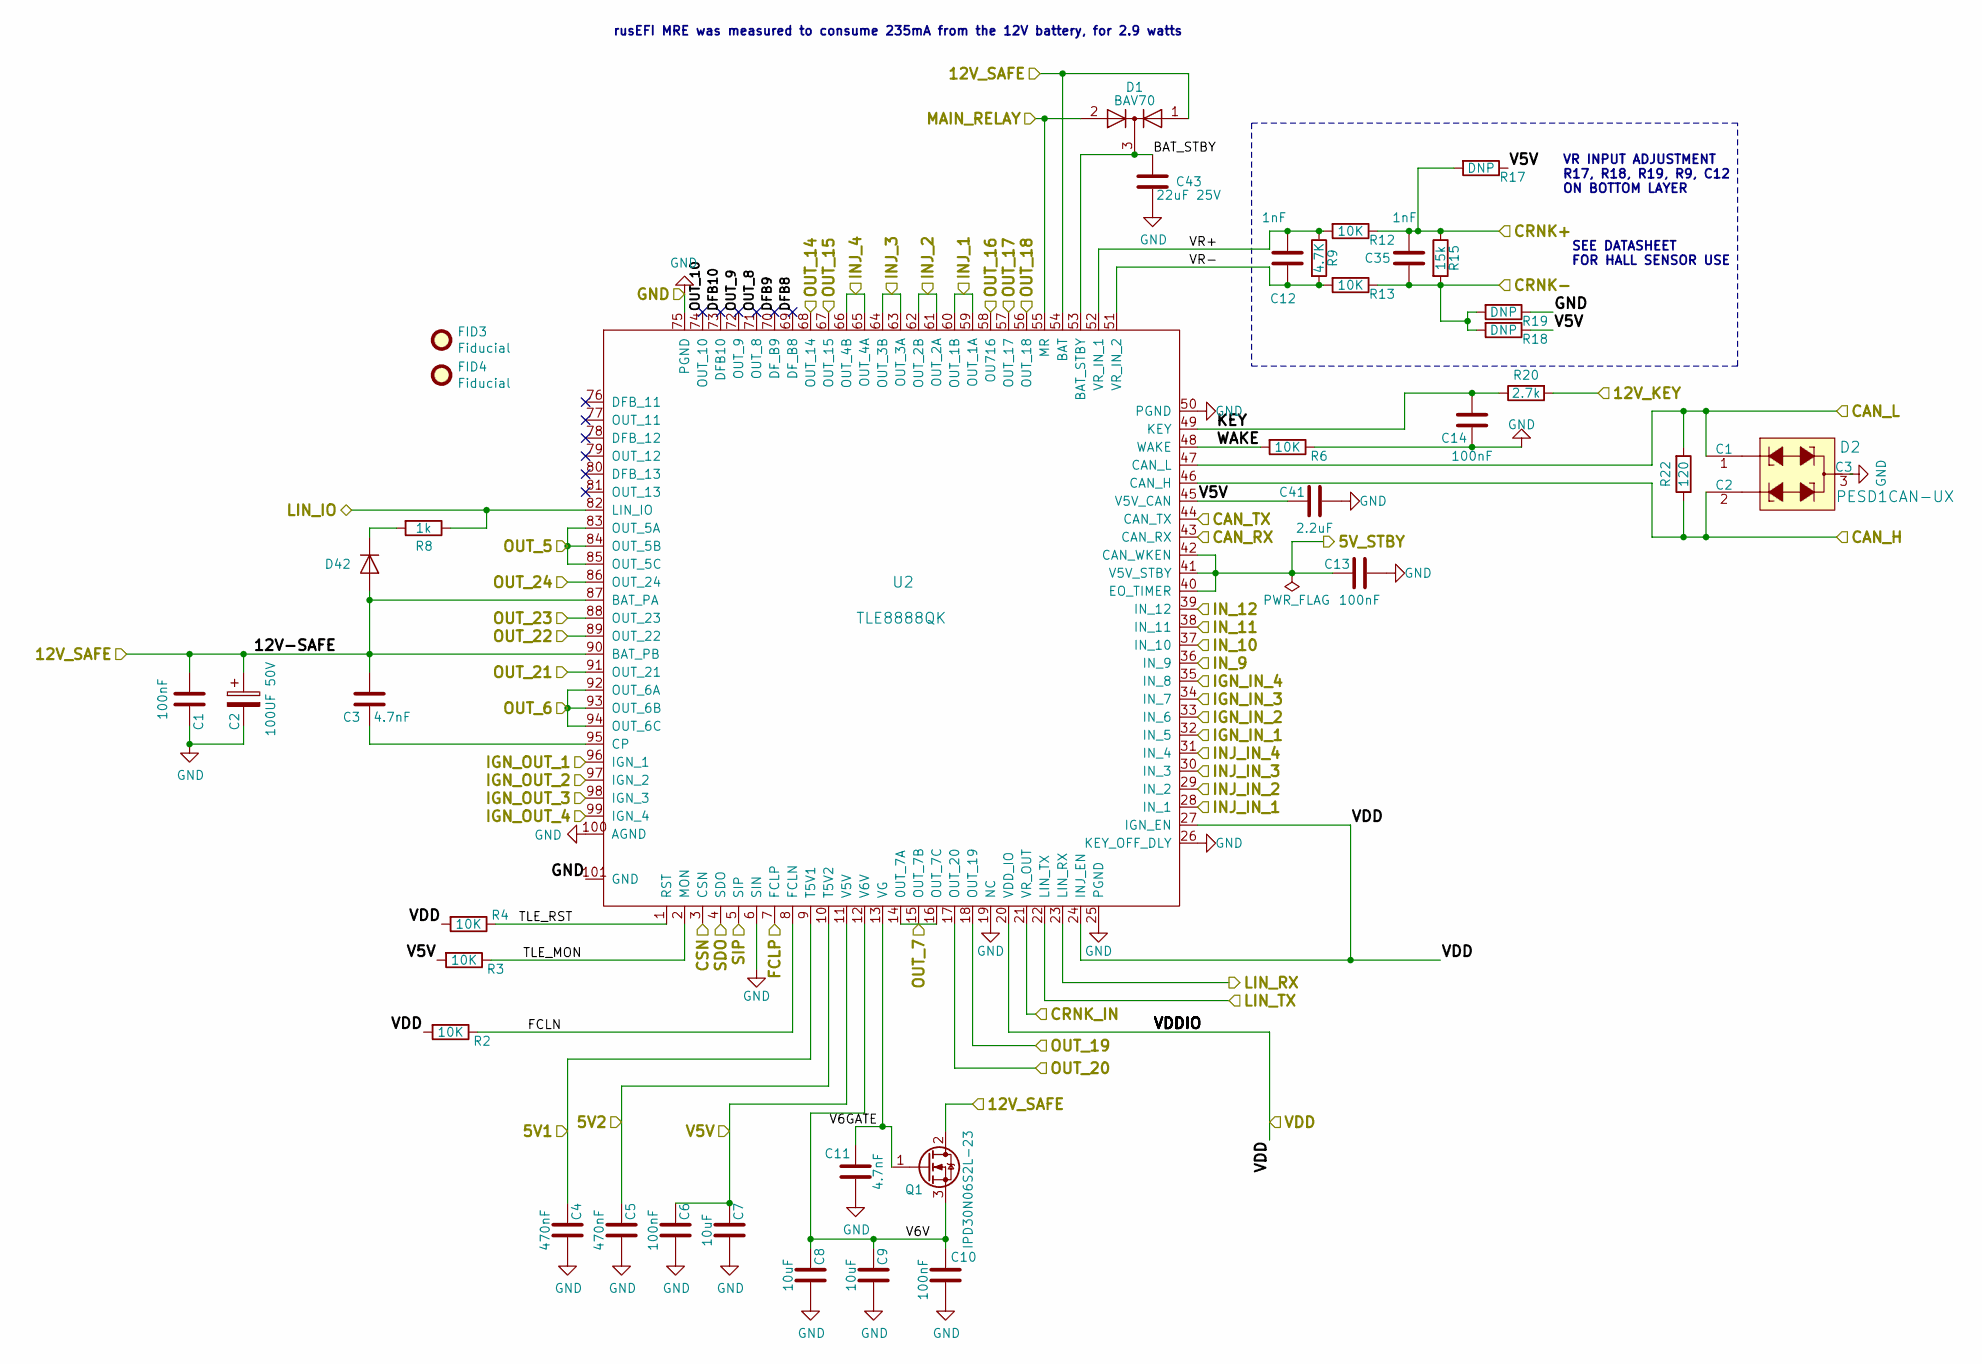
[picture p8: schematic TLE8888-1QK.sch, microRusEfi-2L]

Parts:
C1, C6, C10, C13, C14: 100nF; C_0603_1608Metric; Part # C0603C104J5RACTU; LCSC C14663
C2: 100UF 50V; CP_Elec_8x10.5; Part # UCD1H101MNL1GS
C3, C11: 4.7nF; C_0603_1608Metric; Part # CGA3E2X7R1H472K080AA; LCSC C53987
C4, C5: 470nF; C_0603_1608Metric; Part # CGA3E3X7R1H474K080AE; LCSC C1623
C7, C8, C9: 10uF; C_0603_1608Metric; Part # C1608X5R1E106M080AC; LCSC C19702
C12, C35: 1nF; C_0603_1608Metric; Part # GRM1885C1H102FA01D; LCSC C1588
C41: 2.2uF; C_0603_1608Metric; LCSC C23630
C43: 22uF 25V; C_0805_2012Metric; Part # C1608X5R1E106M080AC; LCSC C45783
D1: BAV70; SOT-23; LCSC C68978
D2: PESD1CAN-UX; SOT-23; Part # PESD1CANUX
D42: 1N4148WS; D_SOD-323; Part # NSR0530HT; LCSC C2128
FID3, FID4: Fiducial; Fiducial_0.5mm_Mask1mm; Part # DNP
Q1: IPD30N06S2L-23; TO-252-2; Part # IPD30N06S2L23AT3
R2, R3, R4, R6: 10K; R_0603_1608Metric; LCSC C25804
R8: 1k; R_0603_1608Metric; Part # RMCF0603JJ1K00; LCSC C21190
R9: 4.7K; R_0603_1608Metric; LCSC C23162
R12, R13: 10K; R_0603_1608Metric; Part # RMCF0603JT10K0; LCSC C25804
R15: 15k; R_0603_1608Metric; Part # RMCF0603JG15K0; LCSC C22809
R17, R18, R19: DNP; R_0603_1608Metric; Part # DNP
R20: 2.7k; R_0603_1608Metric; Part # RMCF0603FT2K70; LCSC C13167
R22: 120; R_0805_2012Metric; LCSC C17437
U2: TLE8888QK; LQFP-100_14x14mm_P0.5mm_THERMAL; Part # TLE88882QKXUMA1

Connections:
/5V: C6.1, C7.1, C41.1, R3.2, R17.1, R18.1, U2.11 (V5V), U2.45 (V5V_CAN); also elsewhere on the board
/5V1: C5.1, U2.10 (T5V2); also elsewhere on the board
/5V2: C4.1, U2.9 (T5V1); also elsewhere on the board
/12V_KEY: R20.2; also elsewhere on the board
/12V_SAFE: C1.1, C2.1, C3.1, D1.1 (A), D42.2 (A), Q1.2 (D), U2.54 (BAT), U2.87 (BAT_PA), U2.90 (BAT_PB); also elsewhere on the board
/CANH: D2.2 (C2), R22.1, U2.46 (CAN_H); also elsewhere on the board
/CANL: D2.1 (C1), R22.2, U2.47 (CAN_L); also elsewhere on the board
/CRANK: U2.21 (VR_OUT); also elsewhere on the board
/CRNK+: C35.1, R12.1, R15.1, R17.2; also elsewhere on the board
/CRNK-: C35.2, R13.1, R15.2, R18.2, R19.2; also elsewhere on the board
/CS_TLE: U2.3 (CSN); also elsewhere on the board
/GP1: U2.91 (OUT_21); also elsewhere on the board
/GP2: U2.89 (OUT_22); also elsewhere on the board
/GP3: U2.88 (OUT_23); also elsewhere on the board
/GP4: U2.86 (OUT_24); also elsewhere on the board
/INJECTOR-1: U2.59 (OUT_1A), U2.60 (OUT_1B); also elsewhere on the board
/INJECTOR-2: U2.61 (OUT_2A), U2.62 (OUT_2B); also elsewhere on the board
/INJECTOR-3: U2.63 (OUT_3A), U2.64 (OUT_3B); also elsewhere on the board
/INJECTOR-4: U2.65 (OUT_4A), U2.66 (OUT_4B); also elsewhere on the board
/LINBUS: R8.1, U2.82 (LIN_IO); also elsewhere on the board
/LS1: U2.92 (OUT_6A), U2.93 (OUT_6B), U2.94 (OUT_6C); also elsewhere on the board
/LS2: U2.83 (OUT_5A), U2.84 (OUT_5B), U2.85 (OUT_5C); also elsewhere on the board
/MAIN_RELAY: D1.2 (A), U2.55 (MR); also elsewhere on the board
/SCK: U2.7 (FCLP); also elsewhere on the board
/SI: U2.5 (SIP); also elsewhere on the board
/SO: U2.4 (SDO); also elsewhere on the board
/TLE8888-1QK/5V_STBY: C13.1, U2.40 (EO_TIMER), U2.41 (V5V_STBY), U2.42 (CAN_WKEN); also elsewhere on the board
/TLE8888-1QK/BAT_STBY: C43.1, D1.3 (K), U2.53 (BAT_STBY)
/TLE8888-1QK/CAN_RX: U2.43 (CAN_RX); also elsewhere on the board
/TLE8888-1QK/CAN_TX: U2.44 (CAN_TX); also elsewhere on the board
/TLE8888-1QK/DFB8: U2.69 (DF_B8)
/TLE8888-1QK/DFB9: U2.70 (DF_B9)
/TLE8888-1QK/DFB10: U2.73 (DFB10)
/TLE8888-1QK/FCLN: R2.1, U2.8 (FCLN)
/TLE8888-1QK/IGN_OUT_1: U2.96 (IGN_1); also elsewhere on the board
/TLE8888-1QK/IGN_OUT_2: U2.97 (IGN_2); also elsewhere on the board
/TLE8888-1QK/IGN_OUT_3: U2.98 (IGN_3); also elsewhere on the board
/TLE8888-1QK/IGN_OUT_4: U2.99 (IGN_4); also elsewhere on the board
/TLE8888-1QK/INJ_IN_1: U2.28 (IN_1); also elsewhere on the board
/TLE8888-1QK/INJ_IN_2: U2.29 (IN_2); also elsewhere on the board
/TLE8888-1QK/INJ_IN_3: U2.30 (IN_3); also elsewhere on the board
/TLE8888-1QK/INJ_IN_4: U2.31 (IN_4); also elsewhere on the board
/TLE8888-1QK/IN_9: U2.36 (IN_9); also elsewhere on the board
/TLE8888-1QK/IN_10: U2.37 (IN_10); also elsewhere on the board
/TLE8888-1QK/IN_11: U2.38 (IN_11); also elsewhere on the board
/TLE8888-1QK/IN_12: U2.39 (IN_12); also elsewhere on the board
/TLE8888-1QK/KEY: C14.1, R20.1, U2.49 (KEY)
/TLE8888-1QK/LIN_RX: U2.23 (LIN_RX); also elsewhere on the board
/TLE8888-1QK/LIN_TX: U2.22 (LIN_TX); also elsewhere on the board
/TLE8888-1QK/OUT_7: U2.14 (0UT_7A), U2.15 (OUT_7B), U2.16 (OUT_7C)
/TLE8888-1QK/OUT_8: U2.71 (OUT_8)
/TLE8888-1QK/OUT_9: U2.72 (OUT_9)
/TLE8888-1QK/OUT_10: U2.74 (OUT_10)
/TLE8888-1QK/OUT_14: U2.68 (OUT_14); also elsewhere on the board
/TLE8888-1QK/OUT_15: U2.67 (OUT_15); also elsewhere on the board
/TLE8888-1QK/OUT_16: U2.58 (OU716); also elsewhere on the board
/TLE8888-1QK/OUT_17: U2.57 (OUT_17); also elsewhere on the board
/TLE8888-1QK/OUT_18: U2.56 (OUT_18); also elsewhere on the board
/TLE8888-1QK/OUT_19: U2.18 (OUT_19)
/TLE8888-1QK/OUT_20: U2.17 (OUT_20)
/TLE8888-1QK/TLE_MON: R3.1, U2.2 (MON)
/TLE8888-1QK/TLE_RST: R4.1, U2.1 (RST)
/TLE8888-1QK/V6GATE: C11.1, Q1.1 (G), U2.13 (VG)
/TLE8888-1QK/V6V: C8.1, C9.1, C10.1, Q1.3 (S), U2.12 (V6V)
/TLE8888-1QK/VR+: C12.1, R9.1, R12.2, U2.52 (VR_IN_1)
/TLE8888-1QK/VR-: C12.2, R9.2, R13.2, U2.51 (VR_IN_2)
/TLE8888-1QK/WAKE: R6.2, U2.48 (WAKE)
/VDD: R2.2, R4.2, U2.20 (VDD_IO), U2.24 (INJ_EN), U2.27 (IGN_EN); also elsewhere on the board
GND: C1.2, C2.2, C4.2, C5.2, C6.2, C7.2, C8.2, C9.2, C10.2, C11.2, C13.2, C14.2, C41.2, C43.2, D2.3 (C3), R6.1, R19.1, U2.6 (SIN), U2.19 (NC), U2.25 (PGND), U2.26 (KEY_OFF_DLY), U2.32 (IN_5), U2.33 (IN_6), U2.34 (IN_7), U2.35 (IN_8), U2.50 (PGND), U2.75 (PGND), U2.100 (AGND), U2.101 (GND); also elsewhere on the board
unnamed: C3.2, U2.95 (CP)
unnamed: D42.1 (K), R8.2

Notes on the sheet:
VR INPUT ADJUSTMENT R17, R18, R19, R9, C12 ON BOTTOM LAYER
SEE DATASHEET FOR HALL SENSOR USE
rusEFI MRE was measured to consume 235mA from the 12V battery, for 2.9 watts

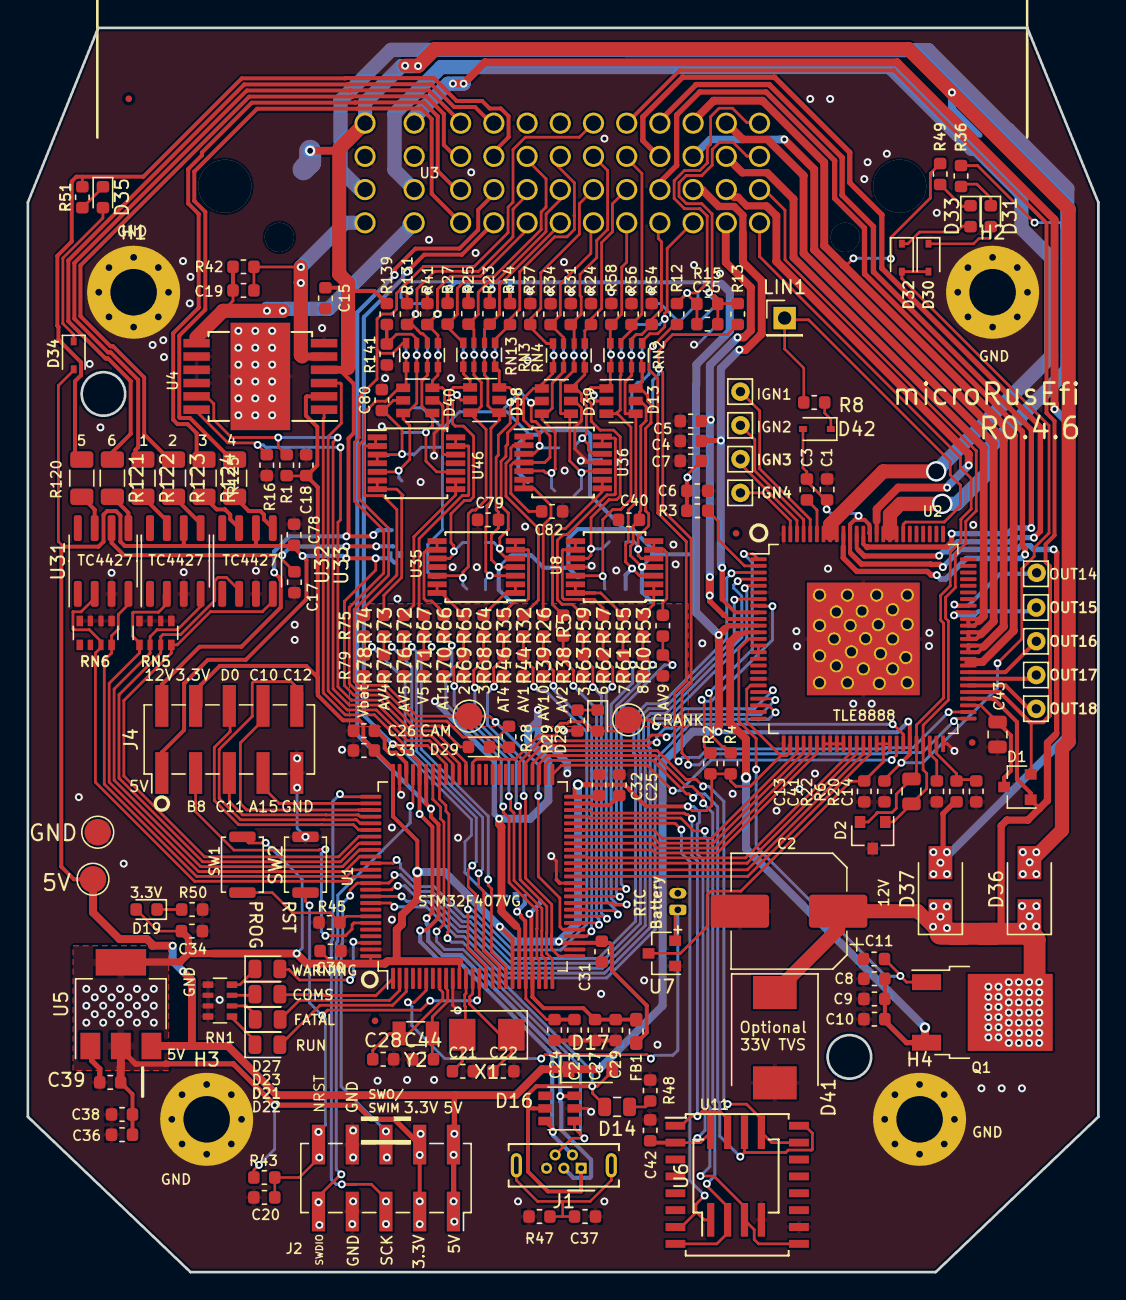
[picture p9: board microRusEfi.kicad_pcb from above]

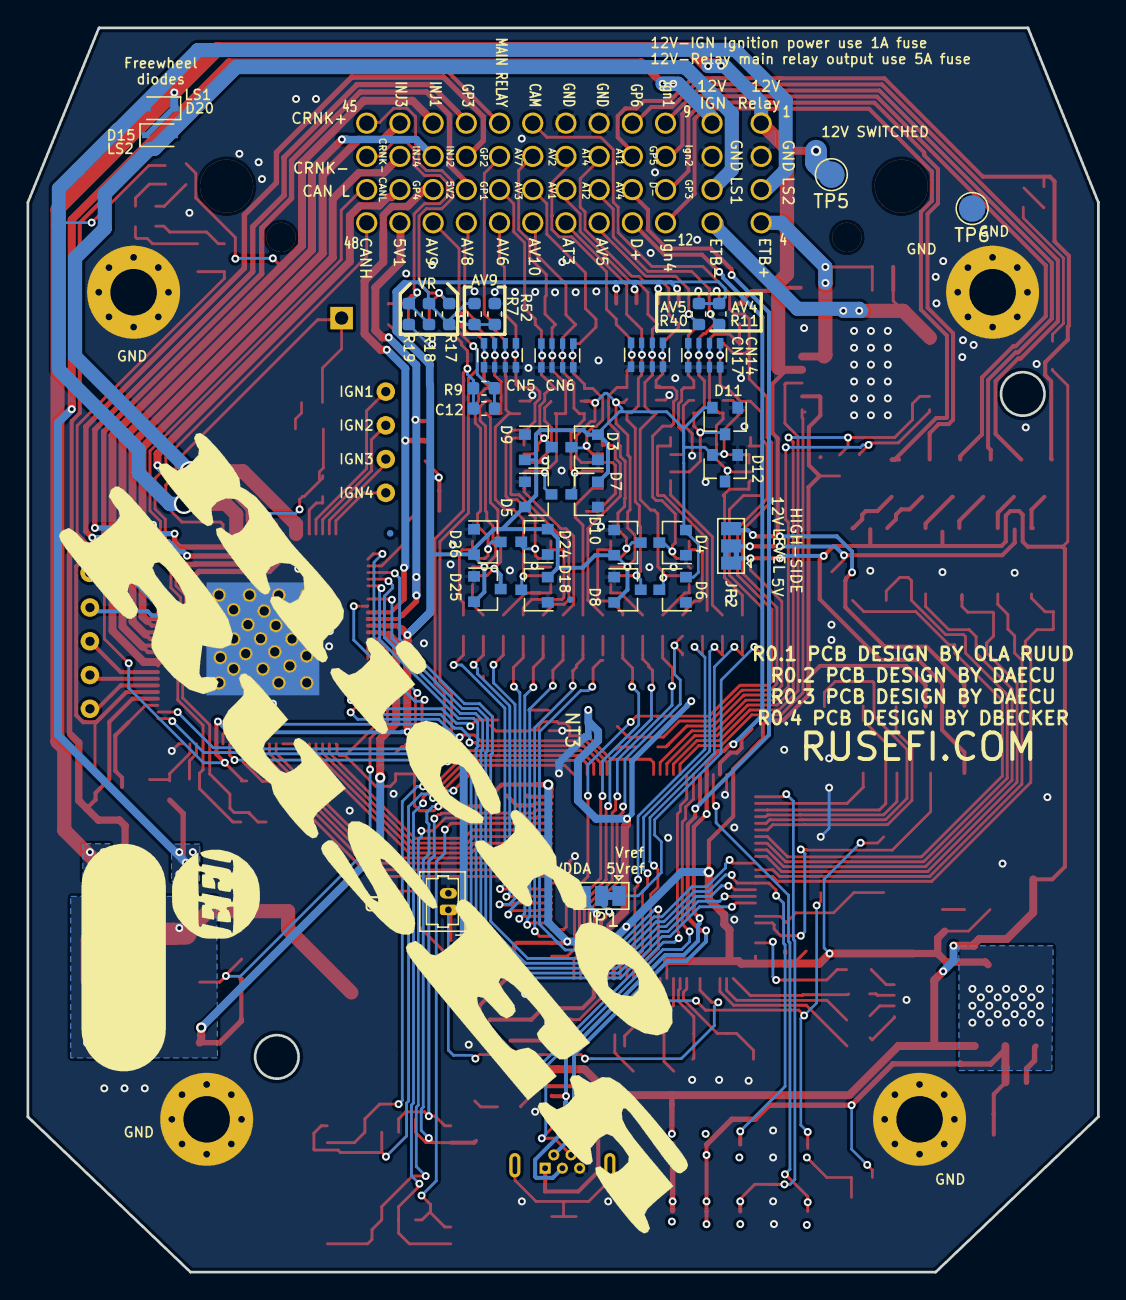
[picture p10: board microRusEfi.kicad_pcb from below]

Board: 2 copper layers, 80.6 x 93.7 mm, 242 parts (38 on the bottom side), 204 nets.
