pddenhar/hw_microRusEfi/(commit log)

2019-10-25 Fix broken rescue symbol on schematic (LOGO)
    [FlashMemory.sch, TLE8888-1QK.sch, TLE9201SG.sch, adc.sch, hi-lo.sch, microRusEfi.sch, stm32.sch]
2019-10-25 Replace micro USB connector with through hole version
    [FlashMemory.sch, TLE8888-1QK.sch, TLE9201SG.sch, adc.sch, hi-lo.sch, microRusEfi.kicad_pcb, microRusEfi.sch, stm32.sch]
2019-10-25 Use mounting hole components on PCB instead of vias with filled zones
    [microRusEfi.kicad_pcb, microRusEfi.sch]
2019-10-25 Rotate USB connector to follow wide-side-down orientation expectation.
    [microRusEfi.kicad_pcb]
2019-10-25 Remove thermal breaks from bottom layer TLE8888 pad
    [microRusEfi.kicad_pcb]
2019-10-25 Add diode and pull up on linbus. Fix some KiCAD 4.0 footprint problems
    [TLE8888-1QK.sch, microRusEfi.kicad_pcb, microRusEfi.sch]
2019-10-26 Move reset and boot buttons to be next to each other
    [microRusEfi.kicad_pcb, microRusEfi.sch]
2019-10-26 Fix a few DRC errors probably introduced by me
    [microRusEfi.kicad_pcb, microRusEfi.sch]
2019-10-26 Clean up tracks and vias
    [microRusEfi.kicad_pcb]
2019-10-26 Missing GND connection on CRNK-
    [adc.sch, microRusEfi.kicad_pcb]
2019-11-08 Fix mixed up AV4, AV5, 5Vsense, and 12V sense
    [adc.sch, microRusEfi.kicad_pcb, stm32.sch]
2019-11-08 Add 0.4.6 gerbers that were submitted to PCBWay
